gautam1858/shruti/docs/architecture-spec.md

# Shruti — Event-Native Protocol Emulator ASIC: Architecture Spec v1.0

Gautam Ramachandra · 23 September 2026 · v1.0 · Jane Street protocol emulator ASIC competition (Tiny Tapeout, IHP 130nm CMOS5L)

## What Shruti is

Shruti (Sanskrit: "that which is heard") is a protocol emulator ASIC that also listens. Two event-native engines speak UART, SPI and I2C from firmware, with low-speed USB and Manchester transmit as stretch goals. An on-die classifier, the Ear, identifies an unknown bus from its edge timing alone and flags traffic that fits nothing it knows. (Status, 8 Oct 2026: on simulated buses it identifies the classes it was trained on, but its out-of-distribution flag does not yet catch traffic it was not trained on; ear/REPORT.md.)

One hardware event stream (pin edges with 20 ns timestamps) feeds three consumers: firmware that speaks, rule monitors that check, and a learned model that identifies. That shared substrate is the design's one idea; everything else is sized around the memory it needs.

What is hard to copy is not the RTL, which the rules make open. It is the closed loop: the chip captures features of a new bus, the open-source pipeline trains a ternary classifier on the host, the weights load back into silicon, and a formal proof shows the on-die inference is bit-exact to the trained model. That loop needs hardware/ML co-design, edge quantization, waveform classification and verification skill in one team. Establish priority by building in public from day one, with a dated repo and a short write-up.

## Competition alignment

Every stated requirement in the [Jane Street brief](https://blog.janestreet.com/protocol-emulator-asic-competition/) maps to a concrete block; the Ear is the answer to "show us anything else your architecture makes possible".

| Brief requirement | How Shruti meets it |
| --- | --- |
| Tiny CPU with an ISA for reading pins, writing pins, counting cycles, exact timing | Two Event Machines (EMs); every instruction is anchored to a captured edge timestamp, so timing is set by hardware, not by instruction latency |
| Reprogrammable for new protocols after fabrication | EM firmware is host-loaded (32 x 16-bit words per EM); the Ear's weights are host-loaded too, so the identifier is retrainable after tapeout |
| UART, SPI, I2C first | Firmware library with cocotb tests against bus models; FPGA-proven against a USB-UART adapter, SPI flash and an I2C sensor. Status, 8 Oct 2026: the firmware is tested on the ISS against peer-device models and UART transmit runs on the RTL in cocotb; no FPGA build exists yet (planned for 6 Dec) |
| Stretch: low-speed USB | 1.5 Mbit/s = 33 core cycles per bit at 50 MHz; NRZI and bit-stuffing in firmware, CRC5/CRC16 in a small shared hardware unit (optional, ~150 cells) |
| Stretch: 10 Mbit Ethernet | Transmit through a ~150-cell hardware Manchester serializer fed from the OSR, host supplying preamble and CRC32; receive is a further stretch on DDR edge capture; bit periods must be whole cycles, so a 40 or 60 MHz core clock (section 11) |
| JTAG, SWD, PS/2, CAN | Firmware, after the core three; CAN needs an external transceiver and a wait-with-timeout for arbitration |
| Test RTL on an FPGA before the ASIC flow | Tang Nano 20K prototype from week 6; same RTL, same firmware. Status, 8 Oct 2026: not started |
| Novel design and verification methodology | Proof-carrying firmware, every protocol program proven against its contract before it can be loaded (section 10); golden-model differential testing, formal proofs on the scheduler, and a bit-exact formal equivalence proof of the on-die classifier (section 9). Status, 10 Oct 2026: four programs carry proofs (the SPI slave and the I2C target do not yet) and `shruti load` is not built; the Event Machine's scheduler, FIFO, PC and HALT properties are proved (verify/README.md); the classifier proof is planned for 13 Dec |
| IHP 130nm CMOS5L, Tiny Tapeout template, 8x4 tiles (confirmed by the organisers in November 2026; designed at 6x4 until then) | Budget in section 8 targets 60% utilisation; the area 8x4 adds goes to a third EM, 64-word program memory or full-size Watch, decided on the first 8x4 run |
| Open source | Apache-2.0 for RTL, firmware, models and the training pipeline; public repo from day one |
| Teams recommended | Planned as two roles (microarchitecture + physical design; ISA, toolchain, Ear, verification and write-up); decided 23 Sep 2026 to proceed solo, with the no-partner fallback in section 14 |
| Deadline 18 Jan 2027, March 2027 shuttle | Feature freeze 20 Dec 2026, submission 12 Jan 2027 (section 15) |

## Architecture overview

One event stream, three consumers: the Event Machines speak, the Ear listens, the monitors watch, and the flight recorder keeps the last 32 events for the host.

```mermaid
flowchart LR
  P[Bus pins<br/>8 bidir + 4 input-only] --> F[Sync + glitch filter<br/>2-of-3, 3-of-5 or bypass]
  F --> E[Edge detect +<br/>24-bit timestamp]
  E --> EM[Event Machines x2<br/>speak]
  E --> FX[Feature extractor<br/>speed-invariant]
  FX --> EAR[Ear classifier<br/>ternary MLP]
  E --> RM[Rule monitors x4]
  E --> RB[Flight recorder<br/>32-entry ring]
  EAR --> TR[Trigger logic]
  RM --> TR
  TR --> RB
  EM --> SCH[Scheduler<br/>time-compare]
  SCH --> P
  H[Host SPI +<br/>register map] --> EM
  H --> EAR
  RB --> H
  TR --> IRQ[IRQ + class LEDs]
```

Edges enter on the left, get filtered and timestamped once, and fan out to every block; only the scheduler drives pins, and only the host loads programs and weights. Single clock domain at a 50 MHz target (24 MHz fallback), synchronous reset, all state in flip-flops unless the SRAM rule in section 8 fires.

## Event-native datapath and ISA

Every timing-critical instruction is anchored to T, a per-EM time register that hardware sets to the timestamp of the last matched edge, so the edge decides the timing and instruction latency never does. This is the honest answer to "what would you do differently from PIO": PIO counts delays from when an instruction runs; Shruti schedules from when the bus event happened. The lineage is the channel time latches of NXP's eTPU, credited openly.

Per-EM state: PC (5 bits), T (24 bits) with a T_PASSED bit, X and Y counters (16 bits each), a bit-period register P (16 bits), ISR and OSR shift registers (16 bits each, with 5-bit counters), a shift configuration register (bit order, word length and autopull/autopush threshold per direction), two scheduler slots (24-bit compare, pin, value), a 12-bit pin snapshot latched at the last matched edge, per-pin push-pull/open-drain mode, and the TO, LATE, OVF and UNF flags. Instructions are 16 bits: a 4-bit opcode and 12 bits of operands; 32 words per EM. The encoding table below is a summary; [isa/isa.yaml](../isa/isa.yaml) (v1.1) is normative, and [isa-decisions.md](isa-decisions.md) records why each choice was made.

| Op | Instruction | Operands (bits 11..0) | Behaviour |
| --- | --- | --- | --- |
| 0 | HALT | reserved | Stop, raise IRQ. Opcodes 12-15 and illegal operands also halt, so blank (all-zero) program memory halts |
| 1 | WAIT pin, mode [, 2^n] | pin 4, mode 3, timeout 5 | Block until rise, fall, any edge, high or low level; T := match cycle, snapshot latched. Timeout 2^n cycles after T (n = 1..23): TO := 1, T := deadline, continue |
| 2 | OUT pin, v @T+d | pin 4, value 2, d 6 | Arm a scheduler slot to drive pin at exactly T+d (d = 0..63). v = 0, 1, OSR (consumes exactly one bit) or ~OSR (next bit inverted, not consumed). Blocks only while both slots are busy |
| 3 | IN pin @T+d / IN pin @snap | pin 4, snap 1, d 6 | Block until T+d and sample the pin, or read the snapshot without blocking; the bit goes into the ISR |
| 4 | ADDT d [, now] | now 1, d 11 | T := T + d, or T := max(T, counter + d): the anchor never moves backwards |
| 5 | ADDT P[/2\|/4\|/8] [, now] | now 1, shift 2 | As ADDT with d = P >> shift, so firmware never hard-codes the bit rate |
| 6 | SHIFT out\|in, lsb\|msb, n [, auto] | dir 1, msb 1, auto 1, n-1 4 | Configuration only: bit order, word length n (1..16) and the autopull/autopush threshold |
| 7 | PUSH [block] | block 1 | ISR word (1 or 2 bytes) to RX FIFO; non-blocking on full drops it and sets OVF |
| 8 | PULL [block] | block 1 | TX FIFO to OSR (1 or 2 bytes); non-blocking on empty leaves the OSR unchanged |
| 9 | SET pin, v [, pp\|od] / SET X\|Y\|P, imm | target 2, then pin 4, level 1, od 1 or imm 10 | Immediate pin drive and mode, or register load (0..1023; the host writes all 16 bits of P) |
| 10 | JMP [cond,] target | cond 3, pin 4, target 5 | always, TO, LATE, TXE (TX FIFO empty), !OSRE (OSR not empty), X--!=0, Y--!=0, pin high, pin low on any of the 12 pins |
| 11 | SYNC set\|wait, n | op 1, flag 2 | Four flags shared by the EMs and the host; wait blocks until the flag is set, then clears it |

Timing model: one cycle per instruction unless it blocks; all time comparisons are modulo 2^24, and a time t is in the future iff (t - counter) mod 2^24 is in [1, 2^23). An OUT@ whose target is not in the future, or an IN@ whose target has passed, still executes but sets the sticky LATE flag; LATE is visible to JMP and to the host, and every firmware contract requires that it is never set. Inputs are seen through the synchroniser, L = 2 cycles late, so a program that runs ahead of its own scheduled outputs should wait on edges rather than levels: a level WAIT can match the pin's old level before a scheduled change becomes visible. At reset T equals the counter, X, Y and P are 0, and CFG is LSB-first with 8-bit words; the host may write P and CFG before starting an EM. A bit period is one "ADDT P" step up to 65,535 cycles (763 baud at 50 MHz); slower rates load P with 1/k of the period and take k steps per bit (300 baud: P = 55,556, three steps).

UART transmit at bit period B (host sets P = B, TX pin push-pull) is twelve words. ISS-verified: the pin trace is cycle-exact for 256 random (byte, B) pairs with B from 8 to 65,535, back-to-back frames are exact down to B = 4, and B <= 2 sets LATE.

```
        SET   tx, 1              ; line idles high
        SHIFT out, lsb, 8        ; LSB first, 8 data bits
top:    PULL  block              ; next byte -> OSR
        ADDT  2, now             ; T := max(T, now + 2): never before the previous stop bit ends
        OUT   tx, 0 @T+0         ; start bit
bit:    ADDT  P                  ; T += B
        OUT   tx, OSR @T+0       ; data bit, consumes one OSR bit
        JMP   !OSRE, bit         ; 8 data bits
        ADDT  P
        OUT   tx, 1 @T+0         ; stop bit
        ADDT  P                  ; T = end of stop bit
        JMP   top
```

Back-to-back bytes start exactly at the end of the previous stop bit; after idle, the start bit follows 2 cycles after the PULL returns. The two scheduler slots throttle the loop so it never runs more than two edges ahead. The v1.0 example (`ADDT 0, now` then `OUT @T+0`) was late by construction, since the slot was armed for a cycle that had already passed; that case is now an ISS regression test.

Three things this gives that PIO does not: hardware WAIT with timeout (needed for CAN arbitration, I2C clock stretching and USB turnaround), deferred hardware sampling at a computed time (a mid-bit read is one instruction), and a snapshot of every pin at the edge so a slave can read data exactly at the clock edge. Measured on the ISS (fw/), the v1.0 claim that UART, SPI and I2C each fit in 12 words was wrong for everything but UART transmit: UART transmit is 12 words, UART receive 17, SPI master 19 in each of modes 0-3 (the mode is set at assembly), and I2C master write (multi-byte, ACK check, clock stretching, STOP and bus-free time) exactly 32, with its bit order set by the host through EMx_CFG. So 32 words hold UART transmit plus receive (29) or SPI master plus UART transmit (31) in one EM, but I2C master fills an EM on its own; SPI slave is 18 words with CPHA = 0 and 15 with CPHA = 1, and an I2C target that receives writes is 32 (with no compare instruction it cannot match addresses, so it stretches SCL while the host answers each byte). I2C speed is set at assembly: the standard build holds SCL low and high for P, the fast build low for P and high for P/2, so 100 kHz (P = 249) and 400 kHz (P = 82) are both exact. Speed limits at 50 MHz, also measured: UART transmit B >= 4 cycles, UART receive B >= 9 (both tested at every common baud rate from 300 to 3 Mbaud, with a three-step SLOW build below 763 baud, where P no longer fits 16 bits), SPI master SCK up to 5 MHz (P >= 5), SPI slave SCK phases of at least 4 cycles, in every mode, I2C target SCL high of at least 4 cycles and low of at least 11.

## The Ear: identifier and retraining loop

The Ear turns raw edge timing into 72 speed-invariant features in hardware, classifies them with a host-loaded ternary MLP, and reports a class, a confidence flag and an out-of-distribution flag. Its per-pin bit-period estimate gives the protocol's speed without any ML.

Speed invariance is the design insight: intervals are coded in the log2 domain (leading-one position plus two mantissa bits, 6 bits total), and the histogram bins each interval by its ratio to the shortest interval seen so far in the window (a running minimum; the histogram shifts when a shorter interval arrives). A 9600-baud UART and a 1-Mbaud UART then produce the same interval histogram, exactly for power-of-two speed ratios and to within a half-octave bin otherwise, which is what lets a model this small generalise; the shortest-interval code and the edge counts still carry the absolute speed (the v1.0 text claimed the whole feature vector was the same, which it is not). In practice the window limits this: at 9,600 baud a 65,536-cycle window (1.3 ms) holds about 6 edges, so the activity gate flags almost every window (ear/REPORT.md, Coverage by speed); a prescaler for the Ear's timebase is planned before the feature freeze. The bit-exact definition is ear/SPEC.md.

| Feature group (4 monitored pins, host-selected) | Per pin or pair | Bits | What it separates |
| --- | --- | --- | --- |
| Interval-ratio histogram, 8 bins (1x, 1.4x, 2x, 2.8x, 4x, 5.7x, 8x, 11x+) | 8 x 6-bit counters | 48 | UART frames vs SPI clock vs Manchester (only 1x and 2x) |
| Shortest interval code (bit period), longest in-burst interval code | 2 x 6 bits | 12 | Speed estimate; CAN (max run 5) vs USB (max run 6) vs UART (up to 9) |
| Edge count and time-high fraction in the window | 2 x 8 bits | 16 | Idle polarity, clock lines (50% duty), activity |
| Pair: b-edges within 4 cycles of an a-edge | 12 pairs x 6 bits | 72 | Differential pairs (USB D+/D-), data-follows-clock |
| Pair: b-edges while a is high | 12 pairs x 6 bits | 72 | I2C (SDA changes only while SCL low, except START/STOP) vs SPI modes |

A window closes after 256 edges or 65,536 ticks, whichever comes first; the features are snapshotted and the counters restart. A tick is 1, 4, 16 or 64 cycles, set by the host (EAR_CFG): at 64 a window spans up to 84 ms, so a 9,600-baud UART or a PS/2 keyboard fills it with edges instead of timing out with a handful. Inference is a serial multiply-accumulate: one ternary weight per cycle into a single 16-bit accumulator (add, subtract or skip), ReLU and a host-set right shift to 8 bits as each hidden unit completes, then an 8-way output layer. 72 x 8 + 8 x 8 = 640 weights at 2 bits plus 8 signed 8-bit hidden-unit thresholds = 1,344 bits, so a full pass takes 640 cycles plus 8 for the argmax, 648 cycles or 13 us at 50 MHz (the v1.0 text said one feature per cycle with 8 accumulators, which contradicts its own ~700-cycle figure and would need 8 adders). Class = argmax; confident = (best - second best) above a host-set margin; OOD = best logit below a host-set floor, plus an activity gate. OOD is the weakest link and is validated empirically (section 9), not assumed.

The retraining loop is what makes the Ear reprogrammable after fabrication, and it is the part competitors will not have:

1. Capture: with the chip watching the new bus, the host reads feature snapshots (72 bytes each) across several speeds and devices; the user supplies the label. A few hundred snapshots per class is enough.
2. Train: quantisation-aware training with ternary weights and integer thresholds (numpy, `python -m shruti train`); every feature is 6 bits, and the pins are presented in a canonical order (sorted by activity) so the model does not depend on which physical pins the bus is wired to. The same pipeline bootstraps the first model from a protocol simulator that emits edge streams with jitter and glitches, before any hardware exists.
3. Verify: a bit-exact Python reference and the RTL (cocotb) run the same snapshots and must produce identical logits; the formal datapath proof in section 9 covers every weight set once.
4. Load: the host writes 1,344 bits over SPI at boot, in under a millisecond.

Shipped as a CLI, `shruti teach`, `shruti train`, `shruti load`, this is the demo: teach the chip an undocumented bus in minutes, with no re-spin. Status, 8 Oct 2026: `shruti train` exists; `shruti teach` and `shruti load` are planned.

## Watch: rule monitors, anomaly trigger, flight recorder

Watch is a hardware protocol trigger with a 32-event pre-trigger memory, the thing a logic analyser does, driven by rules the user writes and by anomalies the Ear learns. It observes only; nothing in Shruti alters the bus.

Four rule monitors, each host-configured: an edge to match (pin, rise, fall or any), a guard over the 12-pin snapshot (mask and value, so "edge on A while B high and C low"), optional bounds on the interval since that pin's previous edge (two 6-bit log codes), and an action: count, trigger, halt the EMs, or set a SYNC flag. Examples: SPI data edge within one cycle after the sampling clock edge (setup violation); UART pulse shorter than half a bit period (glitch or baud mismatch); USB single-ended zero longer than two bit times (reset).

Trigger sources: any rule, the Ear's OOD flag, an Ear class change, the host, or the external trigger-in pin. On trigger the recorder keeps N more events (host-set, 0 to 31) and freezes, raises IRQ, drives trigger-out so a scope can capture the same moment, and optionally halts the EMs. The recorder holds 32 entries of 21 bits: 16 low timestamp bits, 4-bit pin, 1-bit edge, read out over SPI.

Status, 8 Oct 2026: Watch is not built. The first build is the cut level (2 monitors, a 16-entry recorder), grown only if place-and-route leaves room.

Rules and the learned model are complementary on purpose: rules catch the violation you can name, the Ear catches the traffic you cannot, and both land the raw edges in the same buffer. (Status, 8 Oct 2026: the Ear's unknown flag does not yet catch untrained traffic; see the OOD row of the risk table.)

## I/O plan and host interface

Twelve watchable bus pins, a 3-wire host SPI, and five status outputs use all 24 Tiny Tapeout signals; the demo board's own RP2040 is the host, so the demo needs no extra hardware.

| Signal | Use |
| --- | --- |
| uio[7:0] | Bus pins B0-B7, bidirectional. Per-pin push-pull or open-drain mode (OUT value 1 releases the pin), which is how I2C and 1-Wire drive without extra logic |
| ui_in[0..2] | Host SPI: SCK, MOSI, CS_n (mode 0, up to core clock / 8 = 6.25 MHz; v1.0 said / 4, which a slave that synchronises SCK into the core clock cannot meet) |
| ui_in[3] | Trigger-in from a scope or another Shruti |
| ui_in[4..7] | Monitor-only bus pins M0-M3; EMs can WAIT and IN on them, the Ear and monitors can watch them |
| uo_out[0] | Host SPI MISO |
| uo_out[1..2] | IRQ, trigger-out |
| uo_out[3] | Ear confident flag |
| uo_out[4..6] | Ear class, 3 bits, straight to the demo board LEDs: the last window that was confident and not OOD, so the LEDs hold an answer between windows (0 after reset) |
| uo_out[7] | Ear OOD flag |

Register map over SPI (8-bit command, 8-bit address, data; the part built so far, with its timing, is in docs/host-interface.md): PROG0 and PROG1 (32 x 16 bits each), WEIGHTS (1,344 bits), FEATURES (72 bytes, read), RECORDER (32 x 21 bits, read), MON0-3 config, EAR config (4-pin select, margin, floor, window length), EM control (run, halt, reset, PC), EMx_P bit period and EMx_CFG shift configuration, TX and RX FIFOs (4 deep per EM), STATUS (including the sticky LATE, OVF and UNF flags per EM). Every bit of program, weights and configuration is host-loaded; nothing protocol-specific is fixed in silicon.

Electrical: logic levels are whatever the Tiny Tapeout board provides (the organisers confirm 3.3 V I/O on the demo board; pull-ups, transceivers and level shifting go on a Pmod). The firmware library defaults to Tiny Tapeout's recommended Pmod pinouts on `uio` (fw/README.md), so standard Pmods plug in. I2C uses open-drain mode with external pull-ups; low-speed USB needs the external 1.5 kohm pull-up on D- and a level check, proven on the FPGA before it is claimed.

## Memory-first area budget

The design holds about 5,000 bits of state (the table's sum; v1.0 of this text said 5,400) and an estimated 10,900 cells (10,700 without the two Ethernet stretch blocks), against roughly 14,400 usable cells (24 tiles at ~1,000 cells per tile, 60% utilisation for routing and clock tree). That leaves ~24% headroom before the first synthesis run; estimates are pre-synthesis and carry +/-30%, so weekly measured numbers replace them from week five.

| Block | State bits | Est. cells | Note / cut option |
| --- | --- | --- | --- |
| EM program memory, 2 x 32 x 16 | 1,024 | 1,600 | Flops plus 32:1 read mux; cut: share one 32-word memory between EMs |
| Event Machines x2 (registers, decode, shifters, 3 comparators each) | ~400 | 2,400 | Cut: single EM |
| ISA v1.1 additions x2 (P, CFG, T_PASSED, LATE/OVF/UNF, P >> s mux, ADDT-now compare) | ~66 | 300 | Cut: drop the P/4 and P/8 forms |
| Scheduler pin drive, open-drain modes | ~30 | 200 | |
| Pin sync, per-pin glitch filters (bypass, 2-of-3 or 3-of-5 majority; 3-of-5 rejects pulses under 60 ns and suits buses up to a few MHz), edge detect, 24-bit timestamp | ~230 | 400 | |
| Host FIFOs, 4 deep x 8 bits, TX and RX per EM | 128 | 250 | |
| Host SPI, register map, read mux | ~60 | 800 | |
| Feature extractor, 4 pins + 12 pairs | ~600 | 1,200 | Cut: 3 pins, 6 pairs |
| Ear classifier: weights as a shift chain, one 16-bit accumulator, 8 hidden bytes, 8 12-bit logits, argmax | ~1,500 | 2,200 | No feature snapshot: counters pause 648 cycles during inference. Cut: hidden layer 8 to 6 |
| Rule monitors x4 | ~210 | 400 | Cut: 2 monitors |
| Flight recorder, 32 x 21 bits as a shift ring | 672 | 800 | Shift-out readout avoids a read mux. Cut: 16 entries |
| CRC5/CRC16 unit (USB), optional | 16 | 150 | Drop if USB is not attempted |
| Manchester serializer (Ethernet transmit): divider, XOR, differential drive | ~24 | 150 | Stretch (section 11); first on the cut list |
| DDR edge capture, 12 pins (10 ns timestamps) | ~48 | 60 | Stretch; half-cycle paths need explicit timing constraints |
| **Total** | **~5,000** | **10,900** | 14,400 usable at 6x4; ~18,000 at 8x4 |

SRAM decision rule: use one SRAM macro for program, weights and recorder only if a single macro of at least 4 kbit fits in 3 tiles or fewer including its keep-out, checked against the CMOS5L template and the ttihp0p2 SRAM example in week one. Otherwise stay with flip-flops: a first tapeout with no macro carries no LEF, timing-model or placement risk, and the budget above already fits without one.

SRAM check, 23 Sep 2026. The CMOS5L PDK (IHP-Open-PDK at the revision the Tiny Tapeout flow pins) links its SRAM library to the SG13G2 macros, so the ttihp0p2 macros are available. The smallest, RM_IHPSG13_1P_64x16_c2 (1 kbit, one port), is 236.8 x 64.4 um = 15,240 um2; the 16 kbit 1024x16 is 236.8 x 336.5 um, about 2.1 tiles. Read access (clock to data out) is about 5 ns at the slow corner, a quarter of a 20 ns cycle. The rule's premise is wrong, though: one single-port macro cannot serve two EMs fetching an instruction every cycle, the Ear reading a weight every cycle during inference and the recorder writing at the same time, so "one macro for everything" would stall the EMs. The workable form is one 64x16 macro per EM (which also doubles program memory to 64 words), about 30,500 um2 plus keep-out, against 83,900 um2 (2,921 cells, measured) for today's 2 x 32 x 16 flops with their write enables and read muxes. The saving, about 50,000 um2 or 5 to 6% of the core, is not needed at the measured utilisation below, and a macro needs changes to src/config.json and a synchronous-read fetch. Decision: stay with flip-flops; revisit only if placement or routing runs short. The flop memory sits behind one read port per EM, so the swap stays local if it is ever made.

SRAM revisited, 4 Oct 2026, when the Ear pushed density to 64%. The Ear's weights, read strictly in sequence, would suit a single-port macro, and a 256x16 macro (28,100 um2) would replace about 85,000 um2 of flops. But on this shuttle the macro cannot be powered within the rules. Tiny Tapeout's CMOS5L precheck forbids TopMetal1 in projects (tt-support-tools, precheck/tech_data.py), and project power must be Metal4 stripes. The macro's power pins are Metal4 columns inside its own footprint, where Metal1-4 are blocked, so they can only be tied together and to the supply by straps on TopMetal1. The SG13G2 reference design does exactly that, but on SG13G2 the project power grid itself is on TopMetal1. Integrated clock gating would have saved the per-bit hold multiplexers instead, but the library marks its clock-gate cell (sg13cmos5l_lgcp_1) dont_use. Both are open questions for Tiny Tapeout (below). Until then, area comes from the design itself.

Correction, 10 Oct 2026: the SRAM conclusion above was wrong. The organisers confirm that IHP SRAM macros may be used, more than one if they fit and pass precheck, and Ken Pettit's walkthrough (https://kdp1965.github.io/ihp-um-janestreet-prism/ihp_sram_macro.html) powers a 512x32 macro on Metal4 alone, with no TopMetal1:
- the tile's Metal4 power stripes are placed on the macro's Metal4 supply columns (FP_PDN_VPITCH 44.96 um, FP_PDN_VOFFSET 6.15 um);
- PDN_MACRO_CONNECTIONS ties the macro's VDD! and VDDARRAY! to them.

The straps this section said were needed on TopMetal1 are not needed. The walkthrough turns off Magic DRC and the illegal-overlap check and relies on KLayout DRC and LVS. The precheck was updated in September 2026 to accept the macro's marker layers. Whether this passes on Shruti is for a GDS and precheck run to show. The candidates are the Ear's weight ring (read strictly in order) and Watch's recorder (written in order). Moving both should free an estimated 60,000 to 80,000 um2, which is an estimate, not a measurement. Clock gating stays out: the clock-gate cell is still dont_use.

Measured, 23 Sep 2026 (synth/synth.sh: Yosys mapping onto the CMOS5L cells, before placement). The 6x4 die in the Tiny Tapeout flow is 1,289.3 x 710.6 um = 0.92 mm2 (core 0.90 mm2), more than the brief's estimate of 0.7 mm2. Built so far: two EMs, flop program memory, input path, counter, pin drivers, SYNC and the host SPI with its register map, 10,090 cells and 179,000 um2 of cell area, of which 1,826 flip-flops are half. That is about 20% of the core. Per block: one EM 2,872 cells (39,300 um2); host SPI 244 cells (4,400 um2); program memory, input path and register map 3,826 cells (97,300 um2). Against the table above, these blocks came in about 65% over their cell estimates (program memory 2,921 cells, not 1,600; each EM 2,872, not 1,350). The rest of the design, at the same overrun, would bring the total to roughly 18,000 cells and 330,000 um2, about 37% of the core. So the cell-count budget in this section, 1,000 cells per tile, is about half what the measured die holds (average cell 17.8 um2, 60% target density: roughly 30,000 cells). The binding limits are placed density, routing and timing at 50 MHz, not the cell count, and the checkpoint criteria below use them. The GDS action's placed and routed numbers replace these as each block lands.

Placed and routed, 24 Sep 2026 (LibreLane in the GDS action, commit 1d5c2fd): 16,940 cells after buffering and clock tree, 255,000 um2, 28% utilisation, 0 DRC and 0 antenna violations; power about 6.8 mW. Timing at 50 MHz closes at all three corners: setup slack +0.06 ns at slow (1.08 V, 125 C), +7.4 ns at typical and +11.2 ns at fast; no hold violations. The flow reports 16 max-slew warnings at the slow corner. Getting there took three runs. The first missed the slow corner by 5.0 ns and the second by 2.3 ns. Three structural changes closed it, none visible at the ISA level: a registered instruction fetch, a T - counter register, and a registered filter output. The slow-corner margin is thin, and the Ear and Watch will add load on the same input path, so every block that lands from here gets a place-and-route run before the next starts.

Placed and routed with the Ear, 4 Oct 2026 (commit b3ea208): 606,000 um2 of standard cells, 67% utilisation, of which 110,000 um2 are timing-repair buffers; 0 DRC and 0 antenna violations, no hold violations, 12 max-slew and 1 max-cap warnings. Setup slack at 50 MHz is +3.37 ns at typical and +7.76 ns at fast. The slow corner misses by 4.18 ns on 47 endpoints, and every one of them starts at the rst_n pin; no register-to-register path fails. The run before it, without the Event Machine and Ear restructuring, missed by 7.6 ns on register paths. The endpoints are the Event Machine's fetched time operand and its negation. The first fix (commit 8648628) removed a redundant reset term from the operand precompute; the next run missed by 5.71 ns on 67 endpoints, still all from rst_n. The netlist showed why: synthesis shares one 24-bit negator between the jump and sequential operands behind a multiplexer, and the reload condition "reset or stopped" sat in that multiplexer's select, so the reset pin (constrained to arrive 4 ns into the cycle) and its fanout tree of about 4,400 flops still fed the subtract. The operand registers now reload on "stopped" alone; run is itself cleared by reset, so the reload happens one cycle into reset with P already zero, and reset is always held longer than that. The longest combinational path from rst_n to any flop in the synthesised netlist went from 22 cell levels to 8. The differential and gate-level tests pass unchanged.

Third run, 4 Oct 2026 (commit 25841fc): no path from rst_n fails any more. Slow corner -1.73 ns on 23 endpoints, typical +6.35 ns, fast +10.83 ns, 68% utilisation, 0 DRC, no hold violations, 8 max-slew warnings. All 23 endpoints are in Event Machine 1: 22 bits of the operand negation and one byte of the RX push register, all from a single instruction bit. The synthesis log explains the rest. Yosys's resource-sharing pass had merged each EM's two program-memory reads (pc + 1 and the jump target) into one read port, and the two operand shifters into one, because a mux selected between them and the pass could prove they were never needed together. That put the decode of "done" and "jump" in front of an address mux, a 32-way read multiplexer and the operand decode in series, and the merged shifter gave the RX path a false dependence on the memory read. Two changes, neither visible at the ISA level: the jump/sequential choice is now an AND-OR, which keeps both reads live so nothing is merged (the log now reports no shared cells; the cost is about 13,500 um2 of cell area for the second read multiplexer per EM); and the negated operand is gone. "The target is now" is dT + d = 0 and "one cycle away" is dT + d = 1, and A + B = K can be tested bit by bit without carry propagation: A ^ B ^ K must equal the carry K demands from the bit below, (A | B) for K = 0. That removes a 24-bit negator per EM and 46 flops. The identity was checked exhaustively at 10 bits (it is bit-local, so width does not matter), and the differential test compares every cycle against the ISS. In the synthesised netlist the deepest path from the fetched instruction to the operand register went from 27 cell levels to 19.

Fourth run, 5 Oct 2026 (commit 0beaee3): timing at 50 MHz closes at all three corners with margin. Setup slack +4.24 ns at slow (1.08 V, 125 C), +9.63 ns at typical and +11.79 ns at fast; no setup or hold violations (worst hold slack +0.05 ns). 619,000 um2 of standard cells, 69% utilisation, of which 113,000 um2 are timing-repair buffers; 0 DRC and 0 antenna violations; 10 max-slew and 1 max-cap warnings; power about 16 mW. The gate-level test in the GDS action passes on the routed netlist. So Event Machines, program memory, input path, host SPI and the Ear fit the 6x4 die at 50 MHz, with 4 ns of slow-corner margin; Watch has to fit in the remaining density and keep that margin, and gets its own place-and-route run before anything else lands.

Signoff gate, 8 Oct 2026. The GDS workflow now has a signoff job (verify/signoff.py) that reads the post-route metrics. It fails on negative setup or hold slack at any corner, or on DRC, antenna or LVS errors. It warns when slow-corner setup slack is under +4.0 ns or the worst hold slack is under the flow's GRT_RESIZER_HOLD_SLACK_MARGIN. Its first runs were on commits d31dad0, 98096c4 and 3d26e12, which add only CI, the formal properties (inside `ifdef FORMAL`, which the flow never defines) and docs. They reproduce the fcafc0b numbers exactly and pass:
- setup slack +4.24 ns slow, +9.63 typical and +11.79 fast;
- worst hold slack +0.0495 ns;
- 619,342 um2 of cells, 68.6% utilisation, 113,131 um2 of timing-repair buffers;
- 0 DRC and 0 antenna violations.
They warn on the hold margin and on 10 max-slew, 1 max-cap and 308 max-fanout violations, the electrical items left for signoff.

8x4 is confirmed (organisers, November 2026): the die grows from 1,289.3 x 710.6 um to 1,724.2 x 710.6 um, 34% more. The design moves to 8x4 as it is, and the extra area is decided on the first 8x4 run's utilisation and timing: a third EM (2,400 cells), 64-word program memory per EM (1,600 cells; an ISA change, since JMP needs a 6-bit target), or Watch at full size (4 monitors, a 32-entry recorder), keeping utilisation under 65%.

## Verification methodology

The distinctive claim is a bit-exact formal proof that the on-die classifier computes what the trained model computes, for every weight set, on top of a conventional golden-model, formal and protocol-level stack; every method's bug count is reported in the write-up.

1. Golden models first. A cycle-accurate Python ISS for the EMs, with assembler and disassembler round-trip tests, is written before any RTL and is what the firmware library is developed on. The feature extractor and classifier have one bit-exact fixed-point reference shared with the training pipeline's export step.
2. Differential testing. Constrained-random EM programs (valid targets, reachable waits) run on the RTL in cocotb and on the ISS with the same random pin stimulus; pin drives, T values and FIFO contents must match cycle-exactly. Random edge streams do the same for the feature extractor.
3. Protocol level. cocotb bus models for UART, SPI and I2C exercise the real firmware; mutation tests (missing ACK, bad stop bit, injected glitches, clock stretching) must fire the right monitor or trigger.
4. Formal, with SymbiYosys. Scheduler: an armed slot fires at exactly its compare time, never earlier, never twice. Capture: no edge on a filtered pin is lost while an EM waits on it. FIFOs: no silent overflow or underflow. Recorder: after a trigger, exactly N more entries, then frozen. PC always in range; illegal opcode halts.
5. Formal, the classifier. A k-induction invariant over the MAC cycle counter shows each accumulator equals the running dot product of features and ternary weights as specified, for all weights and features; the argmax and threshold logic is proven equivalent to the reference by SAT. The datapath is small enough that this closes; each new weight set then needs only the differential run.
6. ML validation. Held-out captures from the FPGA, at least five devices per class across speeds, give a confusion matrix. OOD is tested by training without JTAG and PS/2 and reporting the flag rate on them against the false-alarm rate on known classes. Glitch and speed-extreme robustness are reported too.
7. Physical. Gate-level simulation of the key tests after place-and-route, timing signoff at 50 MHz, and a 24-hour FPGA loopback soak on real devices.

Status, 8 Oct 2026:
- 1 and 2 are done for the Event Machines and the Ear (test/test.py; 60 random two-EM programs match the ISS every cycle; the Ear's 72 features match ear/features.py window by window).
- 3 is partial: the firmware runs on the ISS against peer-device models, with injected faults (a framing error, a glitch, NACKs, clock stretching; fw/tests); cocotb bus models on the RTL, and the monitors they should fire, are planned.
- 4 is partial: 27 Event Machine properties (scheduler, LATE, WAIT timeouts, FIFOs, PC, HALT) are proved by k-induction, every one with a planted bug that fails it (verify/README.md). Capture and the recorder are planned; the recorder waits for Watch.
- 5 is planned for 13 Dec.
- 6 is on simulated buses only (ear/REPORT.md); FPGA captures wait for the FPGA.
- 7 is done for the current blocks (gate-level simulation and signoff at 50 MHz in CI, spec section 8); the FPGA soak waits for the FPGA.

Traceability: each ISA line maps to an ISS routine, a formal property and a test in a matrix in the repo, and GitHub Actions runs the whole stack on every push, alongside the Tiny Tapeout GDS action. The RTL language is decided in section 12; either way the ISS is the single source of truth and the prover in section 10 sits on top of it.

## Proof-carrying firmware

Every program in the firmware library ships with a machine-checked proof that it meets its protocol contract, produced by `shruti prove` in seconds, and `shruti load` refuses an unproven program unless forced (Status, 10 Oct 2026: four programs carry proofs: UART transmit and receive, SPI master in modes 0-3 and I2C master in both speed builds; the SPI slave and the I2C target are tested but not proved; `shruti load` is not built, so nothing enforces the refusal yet). Nobody proves PIO programs; Shruti's are small enough to prove, and that is the methodology claim the write-up leads with. Silicon cost: zero.

A contract is a short declaration over the pin trace. Per pin, an expected run of intervals as multiples of a symbolic bit period B (tolerance 0 cycles for generated timing, +/-k cycles for sampled timing); invariants such as "no SDA edge while SCL is high except START and STOP" or "data stable for at least s cycles before the sampling edge"; and response bounds such as "replies within N x B of the last input edge". Contracts for UART, SPI, I2C, PS/2 and low-speed USB framing live in the repo beside the programs.

Method: symbolic execution of the ISS. A program is at most 32 words, its loops are bounded by the X and Y counters, and its timing is arithmetic on T, so with the data bytes and B left symbolic the executor produces the pin trace as symbolic edge times and Z3 decides the contract (linear integer arithmetic for timing, bit-vectors for data). The UART transmit contract over all 256 bytes and every B from 8 to 65,535 cycles closes in about 0.5 s (prover v0, two symbolic frames with symbolic arrival times), and broken variants return counterexamples that the concrete ISS reproduces. An induction proof over the loop head then extends it to any number of frames: the base case and the step together take about 0.2 s. Reactive contracts followed: the UART receiver is proved against a symbolic peer with edge jitter up to P/16 (P = 16..65,535, and from P = 9 without jitter margin), and the SPI master's timing and data in both directions against a slave answering 1 or 2 cycles after each edge (P = 5..65,535). The I2C master is proved for one write transaction against a symbolic slave that ACKs or NACKs each byte and stretches the clock, in its standard and fast builds (P = 65..2,000, about 30 s each); the bus-free time between transactions is measured on the ISS but not yet proved. Reactive programs (slave, receive) are checked against a symbolic input trace constrained by the peer's contract.

Chain of trust, stated in the write-up exactly like this: the RTL matches the ISS by bounded formal equivalence of the Event Machine against a Verilog transliteration of the ISS semantics (SymbiYosys, depth at least the longest instruction) plus constrained-random differential testing; the ISS running the program satisfies the contract by Z3. That is a proof at the ISS level with the RTL bounded-equivalent and tested, not "fully verified silicon", and it is still stronger than anything a PIO program has. Status, 8 Oct 2026: the bounded equivalence check is not built. Today the RTL-to-ISS link is cycle-exact differential testing plus 27 SymbiYosys properties of the Event Machine, proved by k-induction against times computed from isa.yaml (verify/README.md).

What it buys in the competition: firmware for a protocol the chip was never designed for is accepted or rejected by the prover, and the accepted program loads with no code review. That is the flexibility the organisers judge first, made checkable. Milestones: UART transmit contract proven by 25 Oct; SPI and I2C by 29 Nov; the "PS/2 firmware, prover accepts" demo by 20 Dec.

## Ethernet stretch: Manchester serializer and DDR capture

10BASE-T transmit is a ~150-cell hardware serializer, not firmware; receive is a further stretch on DDR edge capture. Almost no entry will attempt the brief's second stretch goal, and the demo is unambiguous: a switch's link LED comes on, then tcpdump on a laptop shows a frame sent by a 0.7 mm2 chip.

Transmit: an Event Machine cannot issue an instruction per half-bit at 10 Mbit/s, so Ethernet mode routes the OSR through a Manchester serializer: a programmable divider makes the bit clock, each bit is XORed with it to give the mid-bit transition, and the result drives two bus pins as TX+ and TX-. The host supplies preamble, frame and CRC32; the EM only pulls bytes, and the serializer auto-pulls from the OSR. Link: the EM emits a 100 ns normal link pulse every 16 ms with one scheduled OUT pair, which is what lights the LED.

Clock: a bit period must be a whole number of cycles. At 50 MHz a half-bit is 2.5 cycles, so Ethernet means a 40 MHz core (4 cycles per bit) or 60 MHz (6 cycles per bit); the week-one clock measurement decides, and every timestamp figure in this spec scales with it. 10BASE-T needs +/-100 ppm, which the demo board's crystal-derived clock meets.

Electrical: 3.3 V pins through series resistors into a MagJack transformer, as bit-banged 10BASE-T from microcontroller GPIOs has shown to work; proven on the FPGA before it is claimed, never on silicon first.

Receive: DDR capture samples each pin on both clock edges (two flops and a mux per pin, ~60 cells for 12 pins), giving 10 ns timestamps at 50 MHz. Manchester decode then runs in firmware from the timestamp stream or in a ~150-cell hardware decoder. DDR capture also doubles timing resolution for the Ear and Watch, so it earns its place even if receive never ships; its half-cycle paths need explicit constraints in the flow. Both blocks sit at the top of the cut list.

## Toolchain decision: Hardcaml or Verilog

Decided 23 Sep 2026: Verilog, solo. The Event Machines, host SPI and pin drivers are in `src/` and match the ISS cycle for cycle in cocotb (test/test.py). The reasoning below is kept as it was written.

Decide at the partner meeting on 11 Oct: RTL in Hardcaml if the RTL owner will work in OCaml, otherwise Verilog. The ISS, assembler, prover and Ear pipeline stay in Python either way, and the ISS is the single source of truth: instruction encodings are generated from one table for the ISS, the assembler and the RTL, so the two languages cannot drift.

Why Hardcaml: the judges built it. hardcaml_waveterm expect tests (the ASCII waveforms featured on their blog) and hardcaml_verify (SAT-based bounded checks) are the tools they read fluently, and Hardcaml generates the Verilog the Tiny Tapeout flow needs, so nothing changes downstream. An entry written in their language and tested in their idiom will be read more carefully than one that is not.

Cost and risk: two to three weeks of OCaml ramp for the RTL owner on a design this size; cocotb protocol tests then run on the generated Verilog, and the formal suite runs on it too. If Verilog: the Yosys-synthesisable SystemVerilog subset, cocotb and SymbiYosys, which is fully adequate and only loses the fit bonus. Do not split the difference; one language for all RTL.

## The demo

One five-minute video, recorded on the FPGA prototype in December and re-shot on silicon if chips come back, is the submission's centrepiece; the write-up and the repo exist to back it up. The sequence:

1. Clip the chip onto an undocumented bus: the internal I2C of a cheap consumer device, or a UART console.
2. The Ear's LEDs show the class and the speed register shows the bit period.
3. A Watch rule triggers and the flight recorder dumps the frames.
4. Firmware for the bus is written from its datasheet (or from the captured frames).
5. `shruti prove` accepts it. If a first attempt was rejected, show that too; judges trust a counterexample more than a green tick.
6. `shruti load`, the chip talks to the device, the host shows the data.
7. Ethernet: the switch link LED comes on, then tcpdump shows the frame.
8. Thirty seconds of fuzzing: mutated frames against the device, response latencies read at 20 ns.

Deliverables in the submission: the video, the README pitch, this spec, and a verification report whose centre is a bugs-found-per-method table. The organisers' checklist (9 Oct 2026): a public repository with the RTL, tests and a passing GDS and precheck from the Tiny Tapeout flow; architecture and instruction-set documentation; the assembler with example programs; and a write-up of the verification approach.

## Risks and cut list

The two risks that decide the outcome are area after synthesis and the Ear generalising to real hardware; both have a fallback that still yields a valid submission.

| Risk | Early signal | Response |
| --- | --- | --- |
| Area overrun after synthesis (+20-30% over estimate is normal) | Week-5 yosys cell count above 13,000 | Apply the cut list below, in order |
| Timing does not close at 50 MHz | Post-route slack negative in week 13 | Run at 24 MHz: USB becomes 16 cycles per bit, still workable; Manchester transmit is dropped |
| Ear misclassifies real devices | Confusion matrix below 90% on FPGA captures (on simulated buses the first model reached 86.6%; the Phase B recipe, an exact search on the integer model, reaches 92.8%, and 94.4% with each bus at the prescaler a host would pick, weakest on UART and Manchester) | Fine-tune on FPGA captures; if still weak, ship the Ear as beta and keep features plus bit-period reporting, which are useful alone |
| OOD flag noisy or blind | False alarms above 5% on known classes; or unknown protocols not flagged. Measured on simulated buses (ear/REPORT.md, first model, 8 Oct 2026): 7.5% false alarms; the logit floor flags 0% of a 20 kHz PWM, WS2812 LED data and random edges on four pins, and 0% of held-out JTAG/SWD and PS/2. A distance-to-class-prototype test on the hidden layer flags 15% of JTAG/SWD and 4% of PS/2 at 5% false alarms, or 47% and 4% at 12%. Phase B model before foreign calibration (Nov 2026): 3.8% false alarms; the floor flags none of the foreign signals, and the prototype test flags 25% of JTAG/SWD and 0% of PS/2 at 3% false alarms. Shipped Phase B model (prescaler, MARGIN calibrated against foreign windows): 4.7% false alarms; the floor flags 94% of fast random edges on four pins and none of the PWM, WS2812 or clock windows | No OOD hardware (decided again after Phase B, Nov 2026): the prototype test flags 19% of held-out JTAG/SWD and 26% of PS/2 at 4% false alarms, or 51% and 32% at 12%, which does not earn its area. Ship "answers only when confident". With the first model the confident flag was right 99.5% of the time on known classes and fired on none of the foreign signals except WS2812 with the unused pins idle low (6%). The more accurate Phase B model fired on 95-100% of PWM and random-edge windows and on 60-68% of held-out PS/2 and JTAG/SWD windows. Training against foreign traffic cost too much accuracy in an 8-unit network (85% at the mildest useful setting), so MARGIN is instead the smallest margin that keeps known-class precision at 99% and confident foreign validation windows at 5% or fewer. Shipped: 21% of known windows confident and all right; 0-13% confident on WS2812, clocks and random edges, 3% and 0% on held-out JTAG/SWD and PS/2; but a 20 kHz PWM is still confidently called CAN, and UART, CAN and USB-LS are never confident at that MARGIN. Per-class margins (EAR_MARGIN_K, built in Phase C, Nov 2026) give each class its own: 58% of known windows confident, 99.9% right; USB-LS, I2C and PS/2 now confident on 79-100% of their windows; CAN still never and UART rarely; held-out foreign windows confident 10.5% on the confident bit and 6.7% past the floor, against 7.0% with one margin; WS2812 confident on 16% (as Manchester). EAR_MARGIN still sets all eight, so the one-margin trade-off stays available to the host. Label the floor flag "unknown" rather than "anomaly" and publish the rates |
| CMOS5L template or flow problems (new branch) | Counter does not reach GDS in week 1 | Email asic-competition@janestreet.com and the Tiny Tapeout Discord in week 1, not week 10 |
| No partner by 11 Oct | Decided 23 Sep: solo | No USB, Ear kept. The single-EM cut is not taken: both EMs are already built and verified, and they use about 9% of the core |
| Electrical unknowns on the demo board (open-drain, USB pull-ups) | | Prove on the FPGA; claim only what ran |
| The GDS job hits GitHub's 6-hour limit | Job time near 6 h. Measured on 10 Oct 2026 (PR 2): gds 3 h 26 min, precheck 2 h 52 min, each its own job | Harden locally with the same Tiny Tapeout flow (https://tinytapeout.com/guides/local-hardening/), as the organisers suggest; an 8x4 build with more logic is the likely trigger |
| Time, alongside the day job and other ventures | A missed checkpoint | Cut scope at the checkpoint, never the timeline |

Cut order, cheapest first: 1. Manchester serializer and DDR capture. 2. CRC unit. 3. Monitors 4 to 2. 4. Recorder 32 to 16 entries. 5. Ear to 3 pins, 6 pairs, hidden layer 6. 6. One shared 32-word program memory. 7. Single EM. 8. Drop the Ear; the EM, monitors and recorder are still a complete, novel entry. Never cut: the ISS, the prover, the verification stack, the FPGA proof.

## Milestones to the deadline

Submission is targeted for 12 Jan 2027, six days before the 18 Jan 2027 deadline, with a feature freeze on 20 Dec 2026; the ISS and firmware come before any RTL so the ISA is proven cheap.

| Date | Milestone | Owner | Status |
| --- | --- | --- | --- |
| 4 Oct 2026 | Counter through the CMOS5L template to GDS; logic level, SRAM macro and I/O speed questions answered; Tang Nano 20K and test devices ordered | Gautam | Input path through GDS, precheck and gate-level test on the CMOS5L flow (the early CI failures were billing on a private repo). SRAM checked (section 8). Logic level, I/O speed and ordering pending |
| 11 Oct 2026 | Partner decision; Hardcaml or Verilog decided; core clock chosen (40, 50 or 60 MHz); ISA v1 frozen (this doc) | Gautam | Solo and Verilog, decided 23 Sep. ISA v1.1 reconciled (docs/isa-decisions.md); clock and freeze pending |
| 25 Oct 2026 | ISS, assembler and disassembler; UART, SPI and I2C firmware passing on the ISS; protocol simulator emitting edge streams for training; shruti prove v0 proves the UART transmit contract with symbolic data and bit period | Gautam | ISS, assembler and firmware (UART TX/RX, SPI master, I2C master) done and tested on the ISS; shruti prove v0 proves the UART TX contract for P = 8..65,535, all bytes and arrival times, in about 0.5 s; protocol simulator done (ear/protosim.py) |
| 8 Nov 2026 | EM0 RTL passes differential tests against the ISS; first measured synthesis cell count | Gautam | Done early (23 Sep): both EMs, host SPI and pin drivers match the ISS in every register every cycle over 60 random programs; fw/uart_tx.s sends bytes out of B0; placed and routed at 28% utilisation, 50 MHz met at all corners (section 8) |
| 15 Nov 2026 | Feature extractor RTL with bit-exact reference; first Ear model trained on synthetic data, weights loading over SPI | Gautam | Bit-exact reference done (input path checked against the RTL); first model trained on simulated buses: 86.6% test accuracy for the integer model, 99.5% when confident (92.8% and 99.0% after the Phase B recipe, Nov 2026); the OOD flag failed its held-out-class check (ear/REPORT.md). Ear RTL done 24 Sep: bit-exact to the reference in cocotb (classes, flags and their timing on every window; all 72 features read back over SPI), weights loading over SPI. Placed and routed 5 Oct with the EMs: timing closes at 50 MHz at all corners (+4.24 ns slow), 69% utilisation. Evaluated 8 Oct beyond the test set (ear/evaluate.py): UARTs at 19,200 baud and slower get almost no answers, fast UARTs are called CAN, and the OOD flag misses foreign and held-out traffic; the confident flag is the signal to trust |
| 29 Nov 2026 | Checkpoint: both EMs, host SPI, monitors, recorder and Ear integrated; UART, SPI and I2C pass protocol tests and their contracts are proven; placed density under the flow's 60% target and timing met at 50 MHz, or the cut list applies (v1.0 said a cell count under 13,000, which section 8's measurements show is about half the real capacity) | Gautam | Contracts proven: UART TX (any number of frames), UART RX, SPI master, I2C master (one transaction) |
| 6 Dec 2026 | FPGA bring-up against a USB-UART adapter, SPI flash and I2C sensor; capture dataset started; Ethernet link pulses light a switch LED if the serializer is in | Gautam |  |
| 13 Dec 2026 | Formal suite closes, classifier proof included; Ear fine-tuned on FPGA captures; confusion matrix and OOD numbers recorded | Gautam | Started 8 Oct: 27 Event Machine properties proved by k-induction, each failed by a planted bug, in CI (verify/README.md); OOD numbers on simulated buses recorded (ear/REPORT.md); classifier proof, capture and recorder properties not started |
| 20 Dec 2026 | Feature freeze; low-speed USB, Ethernet frame transmit and the prover-accepted PS/2 firmware demo count only if already passing | Both |  |
| 4 Jan 2027 | Place-and-route, timing signoff at 50 MHz, gate-level simulation of key tests | Gautam |  |
| 12 Jan 2027 | Submission: README, ISA reference, verification report with bugs-per-method table, demo video | Gautam |  |
| 18 Jan 2027 | Jane Street deadline (buffer) | |  |

## Open questions for week one

Eight facts this spec assumes but has not verified; each changes a number above, so they come before any RTL.

- [ ] Maximum core clock and pin toggle rate on the CMOS5L Tiny Tapeout board: decides 50 MHz vs 24 MHz and whether low-speed USB is claimable (organisers, 9 Oct 2026: there is no target clock, so pick one that closes timing after place-and-route; CMOS5L has no silicon back yet and no characterised pad numbers, and Tiny Tapeout is checking for SG13G2 figures)
- [ ] Logic level of the board's I/O (assumed 3.3 V) and whether uio pins can be tri-stated per pin at runtime, which open-drain mode needs
- [x] SRAM macro sizes and area on CMOS5L, from the template and the ttihp0p2 SRAM example: feeds the SRAM rule in section 8 (answered 23 Sep: stay with flops, section 8)
- [x] Whether the 8x4 tile option is confirmed, and by when: decides the third EM vs 64-word memory choice (organisers, November 2026: 8x4 is confirmed for the March 2027 CMOS5L shuttle, tile sizes are final, and the template's main branch targets CMOS5L; the choice is made on the first 8x4 run)
- [x] SRAM macros on the CMOS5L shuttle (organisers, 9 Oct 2026: allowed, more than one, if they fit and pass precheck; powered on Metal4 per the walkthrough in section 8)
- [ ] Whether the dont_use clock-gate cell may be instantiated (section 8)
- [x] Which flow version the cmos5l template branch runs (LibreLane or OpenLane) and whether the GDS GitHub Action works on a fork today (LibreLane 3.1.0.dev3; the GDS, precheck and gate-level jobs pass on this repo)
- [x] Partner: who owns microarchitecture and physical design, whether they will write it in Hardcaml, and by 11 Oct (solo, Verilog, decided 23 Sep)
- [ ] Final 8 Ear classes: UART, SPI, I2C, low-speed USB, CAN, JTAG/SWD, PS/2, Manchester, or swap CAN for 1-Wire
- [ ] Name and licence: check "Shruti" for collisions with existing chips or tools; Apache-2.0 for everything, or CERN-OHL-P for the RTL

One decision with no research needed: publish a short write-up of the architecture at ISA freeze on 11 Oct to establish priority, not after the FPGA works.
