gautam1858/shruti/verify/README.md

# verify: everything that checks the design

cocotb bus models and mutation tests, the constrained-random differential harness (RTL vs ISS), SymbiYosys properties for the scheduler, capture, FIFOs, recorder and the classifier datapath, and the bugs-found-per-method report.
