gautam1858/shruti/test/test.py

# SPDX-FileCopyrightText: 2026 Gautam Ramachandra
# SPDX-License-Identifier: Apache-2.0
#
# Milestone 1 tests: the host SPI, the Event Machines against the ISS (iss/sim.py), the
# UART transmitter firmware out of a pin, and the input filter. Every test runs at RTL and
# on the gate-level netlist; the ones that look inside the design say so and run at RTL only.

import random

import cocotb

from harness import (CFG_OUT, CTRL, EM_BASE, FILTER, FLAGS, GATES, ID, P_LO, RUN_ALL, RXPORT,
                     SYNC, TXPORT, Chip)
import randprog

import fw
from fw.peers import uart_decode
from iss import Sim


async def new_chip(dut):
    chip = Chip(dut)
    await chip.start_clock()
    await chip.reset()
    return chip


# -- host interface ------------------------------------------------------------------------

@cocotb.test()
async def host_spi_registers(dut):
    chip = await new_chip(dut)
    assert await chip.read(ID, 2) == [0x53, 0x11], "ID and ISA version"
    await chip.write(EM_BASE[0] + P_LO, [0x34, 0x12])
    await chip.write(EM_BASE[1] + P_LO, [0xCD, 0xAB])
    assert await chip.read(EM_BASE[0] + P_LO, 2) == [0x34, 0x12]
    assert await chip.read(EM_BASE[1] + P_LO, 2) == [0xCD, 0xAB]
    await chip.write(EM_BASE[0] + CFG_OUT, [0x3F, 0x10])
    assert await chip.read(EM_BASE[0] + CFG_OUT, 2) == [0x3F, 0x10]
    await chip.write(SYNC, [0x5])
    await chip.write(FILTER, [0x2])
    assert await chip.read(SYNC, 2) == [0x5, 0x2]
    assert await chip.read(EM_BASE[0] + CTRL) == [0], "EMs are stopped after reset"
    assert chip.irq == 0


# -- the UART transmitter out of a pin -----------------------------------------------------

TXD = 1         # uart_tx.s drives B1: Tiny Tapeout's Pmod UART TXD, top row


async def run_uart_tx(chip, B, data):
    words = fw.load("uart_tx")
    await chip.setup_em(0, words, P=B, tx=data[:4])
    frame = 10 * B
    cycles = 40 + frame * len(data)
    start = await chip.start(0b01)
    # the rest of the bytes go in while the first ones are on the wire, one per frame
    host_tx = [(0, b) for b in data[:4]]
    for b in data[4:]:
        await chip.ticks(max(0, start + frame * (len(host_tx) - 2) - chip.k))
        await chip.write(EM_BASE[0] + TXPORT, [b])
        host_tx.append((chip.last_rise + 4 - start, b))
    await chip.ticks(start + cycles - chip.k)
    got = chip.pad_trace(start, start + cycles, pins=[TXD])
    ref = Sim([words], P=[B], host_tx=[host_tx], rx_drain=False).run(cycles)
    assert got == ref.trace, "pin B1 differs from the ISS"
    frames = uart_decode([(c, v) for c, _, v in got], 1, B, cycles)
    assert [b for _, b, _ in frames] == data and all(ok for _, _, ok in frames)
    assert (await chip.read_reg(0, FLAGS)) == 0, "no LATE, OVF or UNF"


@cocotb.test()
async def uart_tx_out_of_a_pin(dut):
    """fw/uart_tx.s on EM0 sends bytes on B1 (the Pmod UART TXD pin, uio[1]), matching the
    ISS cycle for cycle."""
    chip = await new_chip(dut)
    rng = random.Random(1)
    for B in ([16, 50] if not GATES else [16]):
        await chip.reset()
        await run_uart_tx(chip, B, [rng.randrange(256) for _ in range(6)])


# -- Event Machines against the ISS --------------------------------------------------------

def probe_em(dut, em):
    u = getattr(dut.user_project, f"u_em{em}")
    g = lambda s: int(getattr(u, s).value)
    return {
        "PC": g("pc"), "T": g("T"), "X": g("X"), "Y": g("Y"), "P": g("P"),
        "OSR": g("osr"), "OSR_COUNT": g("osr_cnt"), "ISR": g("isr"), "ISR_COUNT": g("isr_cnt"),
        "SNAPSHOT": g("snapshot"), "PIN_MODE": g("pin_mode"),
        "TO": g("f_to"), "LATE": g("f_late"), "OVF": g("f_ovf"), "UNF": g("f_unf"),
        "halted": g("halted"), "tx": g("tx_cnt"), "rx": g("rx_cnt"),
        "OUT_N": g("out_n"), "OUT_MSB": g("out_msb"), "AUTOPULL": g("autopull"),
        "IN_N": g("in_n"), "IN_MSB": g("in_msb"), "AUTOPUSH": g("autopush"),
        "txd": [g(f"txm{(g('tx_rd') + i) % 4}") for i in range(g("tx_cnt"))],
        "rxd": [rx_slot(g, (g("rx_rd") + i) % 4) for i in range(g("rx_cnt"))],
    }


def rx_slot(g, k):
    """An RX FIFO slot as the host would read it: a push writes its bytes a cycle after it
    counts them, and the pending bytes are forwarded."""
    n, idx, data = g("rxp_n"), g("rxp_idx"), g("rxp_data")
    if n and k == idx:
        return data & 0xFF
    if n == 2 and k == (idx + 1) % 4:
        return data >> 8
    return g(f"rxm{k}")


def iss_em(em):
    return {
        "PC": em.PC, "T": em.T, "X": em.X, "Y": em.Y, "P": em.P,
        "OSR": em.OSR, "OSR_COUNT": em.OSR_COUNT, "ISR": em.ISR, "ISR_COUNT": em.ISR_COUNT,
        "SNAPSHOT": em.SNAPSHOT, "PIN_MODE": em.PIN_MODE,
        "TO": int(em.TO), "LATE": int(em.LATE), "OVF": int(em.OVF), "UNF": int(em.UNF),
        "halted": int(em.halted), "tx": len(em.tx), "rx": len(em.rx),
        "OUT_N": em.OUT_N, "OUT_MSB": em.OUT_MSB, "AUTOPULL": em.AUTOPULL,
        "IN_N": em.IN_N, "IN_MSB": em.IN_MSB, "AUTOPUSH": em.AUTOPUSH,
        "txd": list(em.tx), "rxd": list(em.rx),
    }


async def differential_case(chip, rng, cycles, per_cycle):
    progs = [randprog.program(rng), randprog.program(rng)]
    Ps = [rng.choice([0, 1, 3, 5, 8, 13, 40]) for _ in range(2)]
    cfgs = [{"OUT_N": rng.choice([7, 3, 15, 0]), "OUT_MSB": rng.randrange(2),
             "AUTOPULL": rng.randrange(2), "IN_N": rng.choice([7, 3, 15, 0]),
             "IN_MSB": rng.randrange(2), "AUTOPUSH": rng.randrange(2)} for _ in range(2)]
    txs = [[rng.randrange(256) for _ in range(rng.randrange(5))] for _ in range(2)]
    stim = randprog.stimulus(rng, cycles)

    await chip.reset()
    for em in range(2):
        await chip.setup_em(em, progs[em], P=Ps[em], cfg=cfgs[em], tx=txs[em])
    probes = {}
    if per_cycle:
        dut = chip.dut

        def probe():
            probes[chip.k] = (probe_em(dut, 0), probe_em(dut, 1), int(dut.user_project.sync.value),
                              int(dut.user_project.cnt.value))
        chip.probe = probe
    start = await chip.start(0b11)
    chip.schedule(start, stim)
    # mid-run host writes: a TX FIFO byte or all four SYNC flags. A write in effect from
    # cycle w is an ISS host action at w.
    host_tx = [[(0, b) for b in t] for t in txs]
    host_sync = []
    host_rx_pop = []
    for _ in range(rng.randrange(4)):
        await chip.ticks(rng.randrange(60))
        r = rng.random()
        if r < 0.3:
            # an RX FIFO read pops each byte when its first bit is clocked
            em, nb = rng.randrange(2), rng.randrange(1, 3)
            await chip.read(EM_BASE[em] + RXPORT, nb)
            host_rx_pop += [(t + 4 - start, em) for t in chip.first_rises[2:]]
        elif r < 0.7:
            em, b = rng.randrange(2), rng.randrange(256)
            await chip.write(EM_BASE[em] + TXPORT, [b])
            host_tx[em].append((chip.last_rise + 4 - start, b))
        else:
            v = rng.randrange(16)
            await chip.write(SYNC, [v])
            host_sync += [(chip.last_rise + 4 - start, f, (v >> f) & 1) for f in range(4)]
    await chip.ticks(max(0, start + cycles - chip.k))
    await chip.write(RUN_ALL, [0])
    stop = chip.last_rise + 4                     # first cycle with both EMs stopped
    chip.probe = None
    n = stop - start                              # ISS cycles 0 .. n-1 ran on the chip

    offset = probes[start][3] if per_cycle else 0   # counter value in ISS cycle 0
    sim = Sim(progs, stimulus=stim, P=Ps, cfg=cfgs, host_tx=host_tx, host_sync=host_sync,
              host_tx_drop=True, host_rx_pop=host_rx_pop, rx_drain=False, step_every_cycle=True, counter_offset=offset)
    where = f"host_tx {host_tx} sync {host_sync} pops {host_rx_pop} P {Ps} cfg {cfgs}"
    landing = ({w for h in host_tx for w, _ in h} | {w for w, _, _ in host_sync}
               | {w for w, _ in host_rx_pop})
    if per_cycle:
        for c in range(n):
            sim.run(c + 1)
            got = probes[start + c + 1][:3]
            want = (iss_em(sim.ems[0]), iss_em(sim.ems[1]), sum(f << i for i, f in enumerate(sim.sync)))
            if c + 1 in landing:
                # the RTL register already holds a host write the ISS applies in cycle c + 1
                host = {"tx": 0, "txd": 0, "rx": 0, "rxd": 0}
                got = ({**got[0], **host}, {**got[1], **host}, 0)
                want = ({**want[0], **host}, {**want[1], **host}, 0)
            if got != want:
                for em in range(2):
                    diff = {k: (got[em][k], want[em][k]) for k in want[em] if got[em][k] != want[em][k]}
                    if diff:
                        raise AssertionError(f"cycle {c}, EM{em} (rtl, iss): {diff}; {where}")
                raise AssertionError(f"cycle {c}: SYNC rtl {got[2]} iss {want[2]}; {where}")
    else:
        sim.run(n)
    got = chip.pad_trace(start, stop)
    want = [e for e in sim.trace if e[0] < n and e[1] < 8]
    assert got == want, f"pin trace differs; first rtl/iss: {got[:4]} / {want[:4]}; {where}"
    for em in range(2):
        rx = await chip.read(EM_BASE[em] + RXPORT, len(sim.ems[em].rx)) if sim.ems[em].rx else []
        assert rx == sim.ems[em].rx, f"EM{em} RX FIFO"
    return n


@cocotb.test()
async def event_machines_match_the_iss(dut):
    """Random two-EM programs and random pin stimulus: pins, RX FIFOs and (at RTL) every
    architectural register, cycle by cycle, against the ISS."""
    chip = await new_chip(dut)
    chip.probe = None
    rng = random.Random(2026)
    cases = 6 if GATES else 60
    for _ in range(cases):
        await differential_case(chip, rng, 400, per_cycle=not GATES)


async def pull_while_full(chip, n):
    """EM0 pulls one byte at cycle n + 2 from a full TX FIFO while the host writes one more.
    Returns the cycle the write takes effect and the TX FIFO count afterwards."""
    from asm import assemble
    prog = assemble(f"SET X, {n}\nw: JMP X--, w\nPULL\nHALT")
    await chip.reset()
    await chip.setup_em(0, prog, tx=[1, 2, 3, 4])
    start = await chip.start(0b01)
    await chip.write(EM_BASE[0] + TXPORT, [9])
    w = chip.last_rise + 4 - start
    await chip.ticks(max(0, start + n + 10 - chip.k))
    return w, await chip.read_reg(0, TXPORT)


@cocotb.test()
async def tx_fifo_write_in_the_cycle_of_a_pull(dut):
    """A host byte written to a full TX FIFO is dropped, unless the EM pulls in that very
    cycle; the ISS (host_tx_drop) agrees at the cycle before, at and after the pull."""
    from asm import assemble
    chip = await new_chip(dut)
    w, _ = await pull_while_full(chip, 1000)
    counts = {}
    for n in (w - 4, w - 3, w - 2):
        w2, counts[n] = await pull_while_full(chip, n)
        assert w2 == w
        prog = assemble(f"SET X, {n}\nw: JMP X--, w\nPULL\nHALT")
        ref = Sim([prog], host_tx=[[(0, b) for b in (1, 2, 3, 4)] + [(w, 9)]], host_tx_drop=True,
                  rx_drain=False).run(n + 20)
        assert counts[n] == len(ref.ems[0].tx), f"PULL at cycle {n + 2}, write at {w}"
    assert counts[w - 3] == 4, "the write in the cycle of the pull is kept"
    assert counts[w - 2] == 3, "a write one cycle before the pull is dropped"


RX_WRAP = """
        WAIT  M0, high           ; latch the snapshot: M0 = 1, M1 = 0
        SET   X, 7
a:      IN    M0 @snap
        JMP   X--, a
        PUSH                     ; 0xFF (8-bit words)
        SHIFT in, lsb, 16
        SET   X, 7
b:      IN    M0 @snap
        JMP   X--, b
        SET   X, 7
c:      IN    M1 @snap
        JMP   X--, c
        PUSH  block              ; 0xFF, 0x00: the FIFO holds three bytes
        SET   X, 7
d:      IN    M0 @snap
        JMP   X--, d
        SET   X, 7
e:      IN    M1 @snap
        JMP   X--, e
        PUSH  block              ; waits for the host to make room, then wraps around
        HALT
"""


@cocotb.test()
async def rx_fifo_two_byte_push_wraps(dut):
    """A 16-bit PUSH whose two bytes straddle the end of the RX FIFO ring."""
    from asm import assemble
    chip = await new_chip(dut)
    chip.m = 0b1101                                  # M1 low
    prog = assemble(RX_WRAP)
    await chip.setup_em(0, prog)
    start = await chip.start(0b01)
    await chip.ticks(start + 80 - chip.k)
    first = await chip.read(EM_BASE[0] + RXPORT, 2)
    pops = [(t + 4 - start, 0) for t in chip.first_rises[2:]]
    await chip.ticks(100)
    rest = await chip.read(EM_BASE[0] + RXPORT, 3)
    end = chip.first_rises[2] + 4 - start
    ref = Sim([prog], initial={9: 0}, rx_drain=False, host_rx_pop=pops).run(end)
    assert first == ref.host_rx[0] == [0xFF, 0xFF]
    assert rest == ref.ems[0].rx == [0x00, 0xFF, 0x00]


async def push_then_read(chip, n):
    """EM0 pushes 0x07 at cycle n + 6 while the host reads the RX FIFO. Returns the cycle at
    which the host's read captures the FIFO head, and the byte it read."""
    from asm import assemble
    prog = assemble(f"""
        WAIT  M0, high
        IN    M0 @snap
        IN    M0 @snap
        IN    M0 @snap
        SET   X, {n}
    w:  JMP   X--, w
        PUSH
        HALT""")
    await chip.reset()
    await chip.setup_em(0, prog)
    start = await chip.start(0b01)
    got = await chip.read(EM_BASE[0] + RXPORT)
    # the read data is captured 3 cycles after the address byte's last SCK edge
    return chip.first_rises[2] - 8 + 3 - start, got[0]


@cocotb.test()
async def rx_fifo_read_in_the_cycle_after_a_push(dut):
    """A push writes its byte a cycle after it counts it; a host read that captures the head
    in between gets the byte by forwarding."""
    chip = await new_chip(dut)
    load, _ = await push_then_read(chip, 800)
    n = load - 7                       # the PUSH executes at n + 6 = load - 1
    load2, byte = await push_then_read(chip, n)
    assert load2 == load
    assert byte == 0x07, f"read {byte:#x}"


# -- input filter, seen through an Event Machine ---------------------------------------------

MIRROR = """
.pin src M0
.pin dst B0
top:  WAIT src, low
      SET  dst, 0
      WAIT src, high
      SET  dst, 1
      JMP  top
"""


async def mirror_edges(chip, mode, pulses):
    """Mirror M0 onto B0 with EM0 and count B0 edges for the given M0 pulse widths."""
    from asm import assemble
    await chip.reset()
    await chip.write(FILTER, [mode])
    await chip.setup_em(0, assemble(MIRROR))
    start = await chip.start(0b01)
    t, stim = 40, []
    for w in pulses:
        stim += [(t, 8, 0), (t + w, 8, 1)]
        t += w + 30
    chip.schedule(start, stim)
    await chip.ticks(start + t + 20 - chip.k)
    return len(chip.pad_trace(start, start + t + 20, pins=[0]))


@cocotb.test()
async def glitch_filter_modes(dut):
    chip = await new_chip(dut)
    # EM0 copies every low pulse on M0 that survives the filter onto B0 (two B0 edges each):
    # bypass passes a one-cycle glitch, 2-of-3 needs two cycles, 3-of-5 three
    assert await mirror_edges(chip, 0, [1]) == 2
    assert await mirror_edges(chip, 1, [1]) == 0
    assert await mirror_edges(chip, 1, [2]) == 2
    assert await mirror_edges(chip, 2, [2]) == 0
    assert await mirror_edges(chip, 2, [3, 8]) == 4


# -- the input path against its bit-exact reference (RTL only: it reads filt_d) -----------------

from ear.inpath import filter_cycles  # noqa: E402


def random_levels(rng, n):
    out, level = [], 0
    while len(out) < n:
        out += [level] * rng.choice([1, 1, 2, 2, 3, 4, 5, 6, 8, 13])
        level ^= 1
    return out[:n]


@cocotb.test(skip=GATES)
async def input_path_matches_reference_model(dut):
    chip = await new_chip(dut)
    rng = random.Random(2026)
    n = 600
    for mode in (0, 1, 2):
        await chip.reset()
        chip.ext, chip.m = 0, 0
        await chip.write(FILTER, [mode])
        await chip.ticks(10)
        u = [random_levels(rng, n) for _ in range(12)]
        base = chip.k + 1
        for k in range(n):
            for p in range(12):
                if k == 0 or u[p][k] != u[p][k - 1]:
                    chip.stim.setdefault(base + k, []).append((p, u[p][k]))
        observed = {}
        chip.probe = lambda: observed.__setitem__(chip.k, int(chip.dut.user_project.filt_d.value))
        await chip.ticks(n + 1)
        chip.probe = None
        for p in range(12):
            filt, _ = filter_cycles(u[p], mode, before=0)
            got = [(observed[base + k] >> p) & 1 for k in range(n)]
            assert got == filt, f"mode {mode}, pin {p}: first mismatch at cycle " \
                f"{next(i for i, (a, b) in enumerate(zip(got, filt)) if a != b)}"


# -- the Ear against ear/features.py and ear/mlp.py ------------------------------------------

import json  # noqa: E402
from pathlib import Path  # noqa: E402

from harness import EAR_BEST, EAR_CFG, EAR_FEATURES, EAR_MARGIN, EAR_MARGIN_K, EAR_RESULT  # noqa: E402

from ear import protosim  # noqa: E402
from ear.features import extract  # noqa: E402
from ear.inpath import filter_pins  # noqa: E402
from ear.mlp import Config, Model  # noqa: E402

EAR_DIR = Path(__file__).resolve().parents[1] / "ear"


def trained_model():
    cfg = json.loads((EAR_DIR / "weights/default.json").read_text())["config"]
    return Model.from_hex((EAR_DIR / "weights/default.hex").read_text(), Config(**cfg))


def random_model(rng, per_class=False):
    """Random weights and configuration; per_class adds random per-class margins, drawn last so
    the tests without them keep their random streams."""
    w = lambda: rng.choice([0, 0, 1, -1])
    m = Model([[w() for _ in range(72)] for _ in range(8)], [[w() for _ in range(8)] for _ in range(8)],
              Config(shift=rng.randrange(7), margin=rng.randrange(40),
                     floor=rng.randrange(-200, 200), min_edges=rng.randrange(0, 257)),
              [rng.randrange(-128, 128) for _ in range(8)])
    if per_class:
        m.cfg.margins = [rng.randrange(40) for _ in range(8)]
    return m


def ear_out(uo):
    return (uo >> 4) & 7, (uo >> 3) & 1, (uo >> 7) & 1          # pins' class, confident, ood


async def ear_case(chip, model, pad_edges, cycles, initial=(1, 1, 1, 1), prescale=1):
    """Drive pad edges (cycle, pin 0-3, level) on B0-B3 from the Ear's first cycle and check
    every classification the reference makes, at the cycle the reference says it lands: the
    confident and OOD pins show the latest window, the class pins the last window that was
    confident and not OOD (0 after reset)."""
    await chip.reset()
    chip.ext = sum(v << p for p, v in enumerate(initial)) | 0xF0
    await chip.ticks(4)
    await chip.load_ear(model, prescale=prescale)
    start = await chip.start_ear()
    chip.schedule(start, [(c + 20, p, v) for c, p, v in pad_edges if c + 20 < cycles])
    await chip.ticks(start + cycles - chip.k)
    edges = filter_pins(list(initial), [(c + 20, p, v) for c, p, v in pad_edges if c + 20 < cycles], 0)
    windows = extract(list(initial), edges, cycles, prescale=prescale)
    shown = ear_out(chip.outs[start])
    assert shown[0] == 0, "class pins are 0 after reset"
    pins = 0
    checked = 0
    for w in windows:
        at = start + w.end + 649                  # first cycle showing this window's result
        if at >= start + cycles:
            break
        r = model.infer(w.features, w.edges)
        chip.ear_held = getattr(chip, "ear_held", 0) + (Model.pins_class(pins, r) != r.cls)
        pins = Model.pins_class(pins, r)
        want = (pins, int(r.confident), int(r.ood))
        before = ear_out(chip.outs[at - 1])
        assert before == shown, f"window at {w.start}: outputs changed before the result was due"
        assert ear_out(chip.outs[at]) == want, \
            f"window {w.start}..{w.end}: rtl {ear_out(chip.outs[at])} reference {want} logits {r.logits}"
        # nothing else moves until the next window's result
        shown = want
        checked += 1
    return checked


def pins_of(cap, rng):
    assign = protosim.random_assignment(cap, rng)
    init, edges = protosim.to_pins(cap, assign)
    return init, edges


@cocotb.test()
async def ear_classifies_protocol_traffic_like_the_reference(dut):
    """The trained weights on simulated UART, SPI and I2C traffic: every window's class,
    confidence and OOD flags, and the cycle they change, match the Python reference."""
    chip = await new_chip(dut)
    rng = random.Random(5)
    model = trained_model()
    total = 0
    cases = [(protosim.uart, dict(period=20)), (protosim.spi, dict(half=6)), (protosim.i2c, dict(half=12))]
    for gen, kw in (cases if not GATES else cases[1:2]):     # gate level: SPI, 5 windows
        cap = gen(rng, duration=14000, **kw)
        init, edges = pins_of(cap, rng)
        total += await ear_case(chip, model, edges, 14000, init)
    assert total >= (6 if not GATES else 3), f"only {total} windows checked"


@cocotb.test()
async def ear_matches_reference_with_random_weights(dut):
    """Random weights, thresholds and configuration on random edges, including simultaneous
    edges on several pins and bursts that fill the histogram's top bin."""
    chip = await new_chip(dut)
    rng = random.Random(9)
    total = 0
    for _ in range(4 if not GATES else 1):
        model = random_model(rng, per_class=True)
        edges, level, t = [], [1, 1, 1, 1], 0
        while t < 9000:
            t += rng.choice([1, 1, 2, 3, 5, 8, 13, 40, 90, 300])
            for p in range(4):
                if rng.random() < 0.4:
                    level[p] ^= 1
                    edges.append((t, p, level[p]))
        total += await ear_case(chip, model, edges, 9000)
    assert total >= (4 if not GATES else 1)
    if not GATES:
        assert chip.ear_held > 0, "no window kept an earlier class on the pins" 


def random_pad_edges(rng, cycles, scale=1, gaps=(1, 1, 2, 3, 5, 8, 13, 40, 90, 300)):
    """Random edges on pins 0-3, gaps in units of `scale` cycles plus a random part of one."""
    edges, level, t = [], [1, 1, 1, 1], 0
    while t < cycles:
        t += scale * rng.choice(gaps) + rng.randrange(scale)
        for p in range(4):
            if rng.random() < 0.4:
                level[p] ^= 1
                edges.append((t, p, level[p]))
    return edges


@cocotb.test()
async def ear_prescaler_matches_reference(dut):
    """EAR_CFG at 4, 16 and 64 cycles per tick: random weights on random edges spread over
    ticks; every window's result and the cycle it lands match the reference."""
    chip = await new_chip(dut)
    rng = random.Random(21)
    total = 0
    for P in ((4, 16, 64) if not GATES else (16,)):
        cycles = 3000 * P + 4000                  # three or more windows of 256 edges
        edges = random_pad_edges(rng, cycles, P, gaps=(1, 1, 2, 3, 5, 8, 13))
        total += await ear_case(chip, random_model(rng), edges, cycles, prescale=P)
    assert total >= (3 if not GATES else 1)
    await chip.write(EAR_CFG, [2])
    assert (await chip.read(EAR_CFG))[0] == 2, "EAR_CFG reads back"


@cocotb.test()
async def ear_per_class_margins_match_reference(dut):
    """Per-class margins at the windows' own gaps: a class's margin is the gap of the first
    window the reference calls that class, plus one for every other class in the order they
    appear, and 255 for classes no window is called. A window's confidence then depends on
    which class's margin the hardware compares, to the last unit."""
    chip = await new_chip(dut)
    rng = random.Random(33)
    total = 0
    for _ in range(3 if not GATES else 1):
        cycles = 30000
        for _ in range(50):                      # random weights often call one class only
            model = random_model(rng)
            pad = random_pad_edges(rng, cycles)
            edges = filter_pins([1] * 4, [(c + 20, p, v) for c, p, v in pad if c + 20 < cycles], 0)
            gaps = {}
            for w in extract([1] * 4, edges, cycles):
                r = model.infer(w.features, w.edges)
                top = sorted(r.logits)
                gaps.setdefault(r.cls, []).append(top[-1] - top[-2])
            if len(gaps) >= 2:
                break
        order = list(gaps)                       # classes in the order windows call them
        model.cfg.margins = [min(255, gaps[k][0] + (order.index(k) % 2)) if k in gaps else 255
                             for k in range(8)]
        assert len(order) >= 2, "the windows should call at least two classes"
        conf = [g >= model.cfg.margins[k] for k, gs in gaps.items() for g in gs]
        assert any(conf) and not all(conf), "margins should split the windows"
        total += await ear_case(chip, model, pad, cycles)
    assert total >= (6 if not GATES else 2)

@cocotb.test()
async def ear_margin_registers(dut):
    """EAR_MARGIN sets all eight per-class margins, as a host written for one margin expects;
    EAR_MARGIN_K sets one class's; both read back."""
    chip = await new_chip(dut)
    assert await chip.read(EAR_MARGIN_K, 8) == [8] * 8, "reset: every margin 8"
    await chip.write(EAR_MARGIN, [77])
    assert await chip.read(EAR_MARGIN_K, 8) == [77] * 8, "EAR_MARGIN sets every class"
    want = [3, 250, 0, 41, 17, 99, 128, 6]
    await chip.write(EAR_MARGIN_K, want)
    assert await chip.read(EAR_MARGIN_K, 8) == want
    assert (await chip.read(EAR_MARGIN))[0] == want[0], "EAR_MARGIN reads class 0's"


@cocotb.test(skip=GATES)
async def ear_prescaled_window_closes_after_65536_ticks(dut):
    """Sparse edges at 4 cycles per tick: the window closes after 262,144 cycles."""
    chip = await new_chip(dut)
    rng = random.Random(4)
    edges = [(100 + 2400 * i, i % 4, (i // 4 + 1) % 2) for i in range(110)]
    assert await ear_case(chip, random_model(rng), edges, 4 * 65536 + 1000, prescale=4) == 1


@cocotb.test(skip=GATES)
async def ear_window_closes_after_65536_cycles(dut):
    """Sparse edges: the window closes on time, not on its edge count."""
    chip = await new_chip(dut)
    rng = random.Random(3)
    edges = [(100 + 600 * i, i % 4, (i // 4 + 1) % 2) for i in range(120)]
    assert await ear_case(chip, random_model(rng), edges, 67000) == 1


@cocotb.test()
async def ear_features_read_over_spi_in_hold_mode(dut):
    """With HOLD set the Ear stops after its first window; the host reads the 72 features
    and the best logit, which match the reference."""
    chip = await new_chip(dut)
    rng = random.Random(4)
    model = trained_model()
    cap = protosim.spi(rng, duration=6000, half=5)
    init, pad = pins_of(cap, rng)
    chip.ext = sum(v << p for p, v in enumerate(init)) | 0xF0
    await chip.ticks(4)
    await chip.load_ear(model)
    start = await chip.start_ear(hold=True)
    pad = [(c + 20, p, v) for c, p, v in pad if c + 20 < 6000]
    chip.schedule(start, pad)
    await chip.ticks(start + 6000 - chip.k)
    w = extract(list(init), filter_pins(list(init), pad, 0), 6000)[0]
    assert (await chip.read(0xB0))[0] & 0x8, "held after the first window"
    await chip.write(EAR_FEATURES, [0])
    assert await chip.read(EAR_FEATURES, 72) == w.features
    r = model.infer(w.features, w.edges)
    res, lo, hi = await chip.read(EAR_RESULT, 3)
    assert res == 0x80 | r.ood << 4 | r.confident << 3 | r.cls
    assert (lo | hi << 8) - ((hi >> 7) << 16) == max(r.logits)


def window_stimulus(rng, style, n=300):
    """Pad edges for one window. 'twins' drives pins in identical pairs; 'delayed' makes pin 1
    a copy of pin 0 two cycles later (equal rank keys, asymmetric pair features) and pin 3
    high for all but one cycle (the divider's boundary); 'slowfast' makes intervals shrink so
    the histogram merges; 'burst' mixes gaps from 1 cycle to 900."""
    if style == "delayed":
        edges, level, t = [], 1, 0
        for i in range(n):
            t += rng.choice([3, 4, 6, 9, 15])
            level ^= 1
            edges += [(t, 0, level), (t + 2, 1, level), (t + 7, 2, level)]
        edges += [(t // 2, 3, 0), (t // 2 + 1, 3, 1)]
        return sorted(edges)
    edges, level, t = [], [1, 1, 1, 1], 0
    gaps = {"twins": [2, 3, 5, 9, 17], "slowfast": None, "burst": [1, 1, 2, 6, 30, 200, 900]}[style]
    for i in range(n):
        if style == "slowfast":
            t += max(1, int(2000 * (0.5 ** (i / 12))) + rng.randrange(3))
        else:
            t += rng.choice(gaps)
        if style == "twins":
            for pair in ((0, 1), (2, 3)):
                if rng.random() < 0.5:
                    for p in pair:
                        level[p] ^= 1
                        edges.append((t, p, level[p]))
        else:
            for p in range(4):
                if rng.random() < 0.45:
                    level[p] ^= 1
                    edges.append((t, p, level[p]))
    return edges


def divider_hits_boundary(h, L):
    """True if restoring division of 64 * h by L passes a remainder of exactly L - 1."""
    r = h
    for _ in range(7):
        if r == L - 1:
            return True
        r = (r - L if r >= L else r) << 1
    return False


def tune_pin3(level, pad, corner):
    """Move pin 3's low pulse to a divider corner:
    'rem' - the division passes a remainder of exactly L - 1 (needs an odd length L);
    'div-', 'div+' - the quotient changes if the divisor is one less, or one more;
    'half' - high time L / 2 with L even, where the remainder lands on exactly L."""
    base = [e for e in pad if e[1] != 3]

    def length(b):
        trial = sorted(b + [(420, 3, 0), (421, 3, 1)])
        return extract(level, filter_pins(level, trial, 0), 400_000)[0].length

    L = length(base)
    want_odd = {"rem": 1, "half": 0}.get(corner)
    if want_odd is not None and L % 2 != want_odd:   # move the closing edge by one cycle
        base = [(c + 1 if c > 430 else c, p, v) for c, p, v in base]
        L = length(base)
        assert L % 2 == want_odd
    if corner == "half":
        return sorted(base + [(420, 3, 0), (420 + L - L // 2, 3, 1)])
    for h in range(L // 2, L - 200):
        q = 64 * h // L
        ok = {"rem": lambda: divider_hits_boundary(h, L),
              "div-": lambda: q != 64 * h // (L - 1),
              "div+": lambda: q != 64 * h // (L + 1)}[corner]()
        if ok and q < 63:
            return sorted(base + [(420, 3, 0), (420 + L - h, 3, 1)])
    raise AssertionError(f"no divider corner '{corner}' for window length {L}")


@cocotb.test()
async def ear_features_match_window_by_window(dut):
    """HOLD after every window, read all 72 features and the result over SPI, compare with
    the reference, release, repeat: rank ties, histogram merges, dividers and bursts."""
    chip = await new_chip(dut)
    rng = random.Random(11)
    model = random_model(rng)
    await chip.load_ear(model)
    styles = ["twins", "delayed", "slowfast", "delayed", "burst", "delayed", "twins", "delayed"]
    first, corners = True, ["rem", "div-", "half", "div+"]
    for style in (styles if not GATES else styles[:4]):     # gate level: rem and div- only
        level = [(chip.ext >> p) & 1 for p in range(4)]
        if first:
            start = await chip.start_ear(hold=True)
            first = False
        else:
            await chip.write(0xB0, [1])                     # release: a new window starts
            start = chip.last_rise + 5                      # after one cycle clearing the old one
            await chip.write(0xB0, [3])                     # and hold again after it
        pad = [(c + 400, p, v) for c, p, v in window_stimulus(rng, style)]
        if style == "delayed":
            assert level[3] == 1, "pin 3 idles high before a delayed window"
            pad = tune_pin3(level, pad, corners.pop(0))
        chip.schedule(start, pad)
        w = extract(level, filter_pins(level, pad, 0), 400_000)[0]
        await chip.ticks(start + w.end + 700 - chip.k)
        assert (await chip.read(0xB0))[0] & 0x8, f"{style}: held"
        await chip.write(EAR_FEATURES, [0])
        got = await chip.read(EAR_FEATURES, 72)
        assert got == w.features, f"{style}: first difference at feature " \
            f"{next(i for i, (a, b) in enumerate(zip(got, w.features)) if a != b)}"
        r = model.infer(w.features, w.edges)
        res, lo, hi = await chip.read(EAR_RESULT, 3)
        assert res == 0x80 | r.ood << 4 | r.confident << 3 | r.cls, style
        assert (lo | hi << 8) - ((hi >> 7) << 16) == max(r.logits), style
        # let this window's stimulus run out, so the next window starts from steady pads
        await chip.ticks(max(0, start + pad[-1][0] + 10 - chip.k))
