gautam1858/shruti/(commit log)

2026-09-23 Shruti: architecture spec v1.0, ISA draft, milestone-0 RTL and tests
    Event-native protocol emulator for the Jane Street protocol emulator ASIC
    competition (Tiny Tapeout, IHP 130nm CMOS5L, 6x4 tiles).
    - docs/architecture-spec.md: full v1.0 architecture (Event Machines,
    Watch, the Ear, proof-carrying firmware, area budget, verification,
    milestones)
    - isa/isa.yaml: instruction set as data, single source of truth
    - src/project.v: milestone 0, synchronisers, selectable glitch filter
    (bypass, 2-of-3, 3-of-5 majority) and per-pin edge strobes
    - test/test.py: cocotb tests for the filter and edge detector
    - info.yaml, docs/info.md: Tiny Tapeout metadata and datasheet
    [isa.yaml, project.v, tb.v, test.py]
2026-09-23 ISA v1.1: reconcile isa.yaml with the spec's ISA section
    The v1.0 draft disagreed with the spec in 18 places; docs/isa-decisions.md
    lists each one and its resolution. Main changes:
    - one 6-bit delay format for OUT@ and IN@, no prescale
    - JMP is cond 3 + pin 4 + target 5, reaching all 12 pins; flag conditions
    are always, TO, LATE, TXE and OSR-not-empty
    - per-EM 16-bit bit-period register P and an ADDT P[/2|/4|/8] form
    - ADDT now is T := max(T, counter + d) with a wrap guard
    - explicit timing model and a sticky LATE flag
    - HALT at opcode 0, WAIT on levels, an explicit snapshot bit for IN
    - SHIFT is configuration; OUT with value OSR consumes one bit
    - corrected 12-word UART transmit example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
    [isa.yaml]
2026-09-23 ISS: decoder generated from isa.yaml and event-driven simulator
    iss/isa.py builds the decode and encode tables from isa/isa.yaml.
    isa.yaml gains a variants map for SET's shared operand bits (metadata only,
    no encoding change).
    iss/sim.py models one or two Event Machines with the shared counter, input
    synchronisation and edge capture, the pin snapshot, two scheduler slots,
    4-deep FIFOs, SYNC flags and push-pull/open-drain pin drive. It skips idle
    cycles; a step-every-cycle reference mode is checked against it.
    [isa.yaml]
2026-09-23 ISS: tests for every instruction and the scheduler rules
    Covers HALT and illegal operands, WAIT modes, timeouts and snapshot, OUT
    timing, OSR consumption and autopull, the two-slot blocking rule, the late
    OUT and IN cases, IN sampling and autopush, ADDT now with counter wrap and
    long idle, ADDT P, SHIFT, PUSH/PULL, SET pin modes, JMP conditions and SYNC.
2026-09-23 UART TX verified on the ISS; spec milestone status
    The 12-word transmit program produces a cycle-exact pin trace for 256
    random (byte, B) pairs with B from 8 to 65,535, back-to-back frames down to
    B = 4, and 300 baud with three ADDT P steps per bit. The spec's UART note
    and the milestone table now record this.
2026-09-23 Assembler and disassembler
    asm/ turns the spec's text syntax into 16-bit words and back, with labels,
    .pin/.equ/.word directives and errors reported with line numbers. Pin names
    move into isa.yaml (pin_names) so the assembler takes them from the ISA.
    Round trips are checked over every instruction form and all 65,536 words.
    [isa.yaml]
2026-09-23 Firmware: UART TX/RX, SPI master, I2C master with peer models
    Four Event Machine programs in fw/, each tested on the ISS against a Python
    model of the peer device: UART TX (12 words) and RX (17), SPI master mode 0
    (19) and I2C master write with ACK check, clock stretching and STOP (32).
    Measured limits at 50 MHz: UART TX B >= 4, UART RX B >= 9, SPI P >= 5.
    The LATE flag caught an SPI bug (two OUTs at T need ADDT 3, now), and the
    I2C tests caught level WAITs matching a pin's stale level while scheduled
    outputs are still in flight; the program waits on edges.
    isa.yaml now states the reset state, and the host may write CFG before
    start (the ISS gains a cfg argument). The spec's claim that eac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
    [isa.yaml, test_firmware.py]
2026-09-23 Prover v0: symbolic execution with Z3 and ISS-confirmed counterexamples
    prove/ executes Event Machine programs with the bit period, data bytes and
    their arrival times symbolic, and checks the contract beside the program
    (fw/uart_tx.contract.yaml) with Z3. LATE is a hard obligation, and every T
    write must stay within 2^23 cycles of the counter so unbounded time matches
    the 24-bit hardware.
    The UART TX contract is proved for P = 8..65,535, every byte and every
    arrival time, in about 0.5 s. Five broken variants each give a
    counterexample that the concrete ISS reproduces. The symbolic executor is
    checked against the ISS on random concrete values.
    python -m shruti prove <program.s> [--min-P] is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
2026-09-23 SPI slave firmware (mode 0), tested against a master model and EM to EM
    fw/spi_slave.s is 18 words. It releases MISO while deselected, reads MOSI
    from the pin snapshot taken at each SCK rising edge, and pushes each byte
    to the RX FIFO. Tests run it against a Python mode-0 master and against
    fw/spi_master.s on the other EM, wired together.
    Measured limits: SCK phases of at least 4 cycles and 5 cycles from CS to
    the first rise; the EM-to-EM pairing needs P >= 9 and misreads silently at
    P = 8.
2026-09-23 Spec: area table with the ISA v1.1 additions; firmware limits in headers
    The area table gains a row for the ISA v1.1 additions (about 66 flops and
    300 cells for both EMs), bringing the estimate to 10,900 cells and ~24%
    headroom. The state-bit figure in the text now matches the table (about
    5,000, not 5,400).
    uart_rx.s states its measured speed limit, and i2c_master.s states that
    the host must flush the TX FIFO after a NACK. requirements.txt lists the
    Python toolchain dependencies.
2026-09-23 Protocol simulator for Ear training data
    ear/protosim.py generates edge streams at the 50 MHz core clock for the
    Ear's eight classes: UART, SPI (modes 0-3), I2C (with clock stretching),
    low-speed USB (NRZI, bit stuffing, keep-alive EOPs), CAN 2.0A (real CRC,
    bit stuffing), JTAG and SWD, PS/2 and Manchester (single-ended or pair).
    Speeds, framing options, gaps and data are random; perturb() adds timing
    jitter and short glitches, and to_pins() maps a bus onto the four
    monitored pins in a random order.
    Every generator is tested by decoding its stream back to the payload it
    encoded. Pure Python, so the cocotb tests can use it too.
2026-09-23 Ear reference: input path, feature extractor and ternary classifier
    ear/inpath.py models the synchroniser, glitch filter and edge detector of
    src/project.v register by register; a new cocotb test checks it against the
    RTL cycle by cycle in all three filter modes. ear/features.py computes the
    72 features per window and ear/mlp.py the ternary classifier and the
    1,280-bit weight chain. ear/SPEC.md is the bit-exact definition the RTL
    must match.
    The spec left some things open or inconsistent, now resolved and recorded:
    the histogram bins against a running minimum and shifts when it drops;
    'longest in-burst interval' is defined; the classifier takes one weight per
    cycle into one accumulator (648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
    [test.py]
2026-09-23 Prover: UART TX proved for any number of frames; forking executor
    The symbolic executor is rebuilt around an explicit machine state so it can
    fork on branches that depend on symbolic inputs, keep only paths whose
    condition is satisfiable, take input waveforms with symbolic edges, and
    start from an abstract state.
    prove_unbounded() proves a contract for an unbounded stream by induction
    over a loop head named in the contract, with an invariant on T, the
    pending slots and the current cycle. For fw/uart_tx.s the base case and
    the step hold for P = 8..65,535, all bytes and arrival times, in about
    0.2 s. Broken variants and a wrong invariant are rejected, and each check
    first confirms its assumpt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
2026-09-23 Prover: UART receiver and SPI master contracts
    Receiver contracts (prove/reactive.py) describe the peer symbolically: 8N1
    frames with symbolic bytes, start times and bounded edge jitter. The
    executor forks on every input-dependent branch, keeps feasible paths, and
    stops at the first path that violates the contract; the counterexample is
    replayed on the ISS. fw/uart_rx.s is proved for P = 16..65,535 with jitter
    up to P/16, and from P = 9 without; P = 8 fails, as on the ISS.
    SPI master contracts (prove/spi.py) leave MISO samples symbolic and tie
    them afterwards to a slave model driven by the program's own CS and SCK
    edges. fw/spi_master.s is proved for P = 5..65,535 (timing, MOSI data,
    MISO d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
2026-09-23 Ear: sorted pins, 6-bit features, thresholds; first trained model
    The feature extractor presents the four pins sorted by activity, so the
    features do not depend on the wiring, and every feature is 6 bits (edge
    counts and time-high fractions drop two bits). The classifier gains an
    8-bit threshold per hidden unit; the weight chain is now 1,344 bits.
    ear/SPEC.md records each change and why.
    ear/dataset.py and ear/train.py build training data from the protocol
    simulator and train the ternary network with quantisation-aware training.
    'python -m shruti train' writes ear/weights/default.{hex,json} and
    ear/REPORT.md. On held-out simulated captures the integer model reaches
    86.6% (99.5% when confide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
2026-09-23 Prover: I2C master contract with a symbolic slave
    prove/i2c.py proves one write transaction of fw/i2c_master.s against a
    slave that ACKs or NACKs each byte, may hold SCL low after every ACK and
    answers 1 or 2 cycles after an edge: the START, SCL low and high phases of
    at least P with stretching included, SDA stable and correct while SCL is
    high, the ACK/NACK handling and NACK flag, and the STOP. P = 65..2,000,
    10 paths, about 25 s.
    The executor gains open-drain lines, input signals rebuilt from the
    program's own drives plus a peer, a WAIT that picks the earliest matching
    edge from an unordered set, and non-blocking PULL that forks on arrival.
    A WAIT may consider only recent edges, but must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
2026-09-23 ISS: host models for the chip's SPI port
    Sim(host_tx_drop=True) loses a byte written to a full TX FIFO instead of
    holding it until there is room, which is what the chip's SPI port does.
    Sim(host_rx_pop=[(cycle, em)]) reads one RX byte at a time, for tests that
    drain the FIFO mid-run. Both are off by default.
2026-09-23 Event Machines, host SPI and pin drivers in Verilog
    src/shruti_em.v implements ISA v1.1 for one Event Machine, cycle-exact
    against the ISS: decode, T arithmetic with a single subtractor, the two
    scheduler slots, OSR/ISR with autopull and autopush, the 4-byte TX and RX
    FIFOs, flags and blocking. src/project.v puts two of them behind the
    12-pin input path and the 24-bit counter, with flop program memory, the
    pin drivers (EM1 wins a same-cycle conflict), the SYNC flags and the host
    register map. src/shruti_spi.v is the host SPI slave (mode 0, SCK up to
    core clock / 8). docs/host-interface.md describes the protocol, the
    register map and its timing.
    The cocotb tests drive the chip through the ho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
2026-09-23 Spec: Verilog and solo, SRAM check, first synthesis numbers
    Records the 23 Sep decisions (RTL in Verilog, solo) and applies the
    no-partner fallback: no USB, Ear kept; the single-EM cut is not taken
    because both EMs are built, verified and small.
    Section 8 gains the SRAM check and the first measured synthesis. SRAM
    macros are available on CMOS5L, but the rule's one-macro-for-everything
    premise cannot serve two EMs fetching every cycle; per-EM macros would
    save about 5 to 6% of the core, which is not needed, so program memory
    stays in flops. The design so far is 10,090 cells, about 20% of the
    0.92 mm2 core, with the blocks about 65% over their cell estimates; the
    1,000-cells-per-tile budget i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
2026-09-23 Event Machine: registered fetch and a T - counter register
    The first place-and-route run met 50 MHz at the typical corner (+4.3 ns)
    but not at the slow corner (1.08 V, 125 C): -5.0 ns worst slack over 247
    endpoints, all in the EM execute paths. The worst ran from the program
    counter through the 32:1 program memory read, decode, two 24-bit adders
    in series and the ISR shift into the RX FIFO.
    The instruction now sits in a register loaded from one of two parallel
    reads, pc + 1 or the jump target, so the memory read is off the execute
    path. dT = T - counter is kept in a register and stepped every cycle, so
    each time comparison is one adder after a flop. No ISA-visible change:
    the cocotb suite s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
2026-09-23 Input path: register the filter output
    The second place-and-route run left 108 slow-corner endpoints failing by
    up to 2.3 ns, every one starting at the filter mode register: the filter
    mux and majority logic, and their high fanout into both EMs, sat in front
    of the execute logic.
    The filter output is now computed one cycle ahead from the earlier
    pipeline stages and registered, so the EMs read the filtered pins from
    flip-flops. The values are cycle-for-cycle the same (the bit-exact test
    against ear/inpath.py and the ISS differential tests pass unchanged), so
    the input latency in the ISA timing model does not move. hist4 is no
    longer needed.
    [project.v]
2026-09-24 Spec: place-and-route results, 50 MHz met at all corners
    The third GDS run of the Event Machine RTL closes 50 MHz timing at the
    slow, typical and fast corners (+0.06, +7.4, +11.2 ns setup slack; no
    hold violations) at 28% utilisation with no DRC or antenna violations.
    Section 8, the milestone table, the README and the verification log
    record it, with the thin slow-corner margin flagged.
2026-09-24 The Ear in RTL, bit-exact to the Python reference
    src/shruti_ear.v implements ear/SPEC.md:
    - windows of 256 edges or 65,536 cycles on 4 host-selected pins;
    - per-pin interval codes and the histogram against a running minimum;
    - in-burst longest interval, edge and time-high counts, and the 24 pair
    counters;
    - a 648-cycle pause: four restoring dividers (7 cycles), the canonical
    rank (1 cycle), then one ternary weight per cycle into one 16-bit
    accumulator, with the argmax folded into layer 2.
    The 640 weights form a ring that turns once per inference; the host
    loads them through a port while the Ear is disabled. HOLD stops after a
    window so the host can read the 72 features over SPI with n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
2026-09-24 Ear: histogram update starts from flip-flops
    The first place-and-route run with the Ear missed 50 MHz at the slow
    corner by 5.0 ns, the worst paths running from the interval counter
    through its log2 code, the compare with the running minimum and the
    histogram shift into the saturating add.
    The code of each pin's interval counter, the compares against the
    minimum and the shortest and longest codes, and the shift distance are
    now computed from the next-cycle state and registered, so the update
    reads them from flip-flops. They always equal the old combinational
    values, so the features do not change: the Ear tests and the planted
    histogram bugs give the same results, and the gate-level suite pa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
    [shruti_ear.v]
2026-10-04 Event Machine: decode the time operand at fetch
    The last place-and-route run, at 64% density, missed 50 MHz at the slow
    corner by up to 7.6 ns, all in Event Machine paths: from the instruction
    through the operand decode (d, 2^n, P >> s), a 24-bit ripple add of
    T - counter + operand, the compares, and the RX FIFO write.
    - The operand of the next word is decoded when it is fetched, using P as
    it will be in the next cycle, and registered with the instruction
    together with its negation.
    - "The target is now" and "the target is next cycle" become equalities
    between registers; the future test needs only the sign of a
    carry-select add.
    - An RX push counts its bytes in its own cycle (so the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
    [shruti_em.v, test.py]
2026-10-04 Ear: pipelined pause schedule, same 648 cycles
    The pause now runs: load the dividers (cycle 0), radix-4 division (1-3),
    rank (4), then a fetch stage that registers each multiply's input a cycle
    ahead (5-644), the multiply (6-645), the argmax on a registered output
    (the cycle after each output), and the flags (647). The total, and so
    every window boundary and the cycle the result lands, is unchanged; all
    Ear tests pass bit-exact.
    The histogram's suffix sums use a parallel prefix with one saturation at
    the end instead of seven saturating adds in series. The longest path
    drops from 105 to 51 gate levels. The "pin always high" divider case
    proved redundant (a planted removal was equivalent) and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
2026-10-04 Spec: SRAM and clock gating checked on CMOS5L; mutation results
    SRAM revisited for the Ear weights: on this shuttle the macro cannot be
    powered within the rules. The precheck forbids TopMetal1 in projects,
    and the macro's Metal4 power pins can only be strapped with TopMetal1.
    The library's clock-gate cell is marked dont_use. Both go to the open
    questions for Tiny Tapeout; area comes from the design meanwhile.
    The verification log adds the planted bugs for the Event Machine and Ear
    restructures.
2026-10-04 Event Machine: keep the reset pin off the operand path
    The first place-and-route run with the Ear missed the slow corner only on
    paths from rst_n: the operand precompute forced P to zero during reset,
    putting the pin in front of the program-memory read and operand adder.
    The term was redundant, since run is 0 in the first cycle after reset and
    that cycle reloads the operand from the cleared P. Record the run's
    numbers in the spec.
    [shruti_em.v]
2026-10-04 Event Machine: reload the time operand on stop only, not on reset
    The second place-and-route run still failed the slow corner only on
    paths from rst_n. Synthesis shares one negator between the jump and
    sequential operands behind a multiplexer, and the reload condition
    "reset or stopped" was in its select, so the reset pin and its fanout
    tree fed the 24-bit subtract. run is cleared by reset, so reloading on
    !run alone covers reset one cycle in. The longest path from rst_n to a
    flop in the synthesised netlist drops from 22 cell levels to 8.
    [shruti_em.v]
2026-10-05 Event Machine: keep both fetch reads live, compare without negating
    The third place-and-route run failed the slow corner on 23 endpoints in
    one EM. Synthesis had merged the two program-memory reads into one port
    behind an address mux selected by done/jump, and the two operand
    shifters into one. Selecting between the jump and sequential words with
    an AND-OR keeps both reads live, so nothing is shared.
    The negated operand is replaced by testing dT + d == 0 and dT + d == 1
    bit by bit without carry propagation, which removes a 24-bit negator
    and 46 flops.
    [shruti_em.v]
2026-10-31 Phase A and firmware: signoff gate, formal properties, Ear evaluation, SPI modes 0-3, I2C 100/400 kHz and target, UART baud rates, Pmod pinouts
    - CI signoff gate on the post-route metrics (verify/signoff.py): fails
    on negative slack, DRC, antenna or LVS errors.
    - 27 SymbiYosys properties of the Event Machine, proved by k-induction;
    31 planted bugs, each caught (verify/).
    - Ear evaluation beyond the test set (ear/evaluate.py, ear/REPORT.md).
    - README and spec: what is built and tested kept apart from what is
    planned, with dated status notes.
    - Assembler: conditional assembly, .define and -D overrides.
    - SPI master and slave in modes 0-3; the master proved in each mode.
    - I2C master at 1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
2026-11-09 Ear: exact search on the integer model, 92.8% on simulated buses
    Gradient training with ternary weights stalled well short of what the
    network can fit: the integer models reached only 84-90% on their own
    training data, against 97.8% for a float network of the same size,
    and restarts varied from 82.5% to 88.6% test accuracy and 19% to 82%
    UART recall. Each restart now ends with an exact search (refine) on
    the integer model as ear/mlp.py defines it: every weight and threshold
    is tried in turn and a change kept only if it lowers the class-
    balanced cross-entropy of the integer logits on the training set. The
    restart with the best balanced validation accuracy is kept, MARGIN is
    the smallest marg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
2026-11-09 Tiny Tapeout: 8x4 tiles and the ttihp27a flow
    The organisers have confirmed 8x4 tiles for the March 2027 CMOS5L
    shuttle, with final tile sizes, and the Tiny Tapeout IHP template's
    main branch now targets CMOS5L with its actions pinned at ttihp27a.
    info.yaml asks for 8x4 (1,724.2 x 710.6 um, 34% more than 6x4) and the
    workflows move from the ihp-cmos5l branch of the GDS action to the
    ttihp27a tag; src/config.json already matches the template. The design
    is unchanged: this run measures it at 8x4, and the extra area (a third
    EM, 64-word program memory or full-size Watch) is chosen from it.
2026-11-09 Ear: class pins hold the last confident answer
    uo_out[6:4] now show the class of the last window that was confident
    and not out-of-distribution (0 after reset), so LEDs on them hold an
    answer instead of changing with every window. The confident and OOD
    pins and EAR_RESULT still describe the latest window, so the register
    map is unchanged.
    Model.pins_class in ear/mlp.py is the reference; the cocotb Ear tests
    check the pins against it at the cycle each result lands, and assert
    that at least one window kept an earlier class. Wiring the pins back
    to the latest class fails both Ear class tests.
2026-11-09 Ear: timebase prescaler (EAR_CFG)
    A window closed after 65,536 cycles (1.3 ms), so slow buses got a
    handful of edges per window and no answer: a 9,600-baud UART about 6.
    EAR_CFG (0xC8, bits 1:0) now sets a tick of 1, 4, 16 or 64 cycles, and
    every time inside a window counts ticks: intervals, the 4-tick near
    window, the 65,536-tick limit and time-high. Ticks start at the
    window's first cycle; edges are still filtered and counted every
    cycle, and the 648-cycle pause is unchanged. At 1 cycle per tick the
    Ear is exactly as before.
    ear/features.py is the reference (ear/SPEC.md has the definition): a
    bus slowed by P at prescale P gives the same window as the original at
    1. The RTL adds a 6-bit co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
2026-11-09 Ear: train and evaluate at the prescaler a host would pick
    Each capture is now cut at the prescaler a host would choose: the
    smallest of 1, 4, 16 and 64 cycles per tick at which the first window
    closes on its edge count (ear/dataset.py, auto_prescale and
    auto_windows). Generators are deterministic per seed, so a slow bus is
    regenerated longer at a bigger prescaler and keeps the same traffic.
    The evaluation's coverage and probe tables use the same rule and show
    the prescaler chosen.
    Slow buses are now answered: a 2,400-baud UART on 96% of windows (0%
    before) and 92% of those right; PS/2 on 100% (34-39%), 99-100% right.
    Test accuracy is 94.4% (92.8%), UART recall 83% (75%).
    MARGIN is now als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
2026-11-09 Docs: no out-of-distribution hardware; Phase B findings and planted bugs
    The spec's decision stands after Phase B: on the shipped model the
    prototype-distance test flags 19% of held-out JTAG/SWD and 26% of PS/2
    at 4% false alarms, which does not earn its area. The verification log
    records Phase B's design findings (gradient training underfitting, noisy
    model selection, the loss of abstention and how MARGIN now handles it),
    the local gate-level limitation, and the planted bugs for the class
    pins and the prescaler. The README's built-and-tested list is dated to
    commit 353dc90.
2026-11-09 Flow: set SYNTH_STRATEGY to AREA 0
    LibreLane 3.1.0.dev4, which the ttihp27a action installs, changed the
    default synthesis strategy from AREA 0 to DELAY 4. The same RTL went
    from 27,789 cells to 44,393. Set AREA 0, the setting every 6x4 run
    used, so this commit's GDS run measures the difference.
2026-11-10 Ear: per-class confidence margins (EAR_MARGIN_K)
    A window is confident when its best logit beats the second by at least
    the margin of the class it is called, set at 0xD0 + k. Writing
    EAR_MARGIN (0xB4) still sets all eight, so a host that writes one
    margin sees no change. 56 more flip-flops and an 8-way byte select.
    The reference model, harness and evaluation use the per-class margin;
    calibrate_classes sets each class against its own validation windows
    and shares the 5% foreign budget between classes. New RTL tests check
    the registers and margins placed at the windows' own gaps; the second
    catches confidence judged against class 0's margin, the wrong class's
    margin, or with > instead of >=.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
2026-11-10 Ear: ship per-class margins; report and docs
    The seeded retrain reproduces the shipped weights exactly and sets
    margins UART 44, SPI 9, I2C 10, USB-LS 25, CAN 59, JTAG/SWD 57, PS/2 23,
    Manchester 47. Confident test windows go from 21% to 58%, 99.9% right;
    USB-LS, I2C and PS/2 become confident on most windows. CAN stays at 0%
    and UART is rare. Held-out foreign windows are confident 10.5% of the
    time on the confident bit (7.0% before): the margins overfit their 30
    calibration windows. Recorded in the README, spec and verification log
    with the planted bugs.
2026-11-10 Docs: the AREA 0 run at 8x4
    Commit f45ddf0's GDS run synthesised 32,802 cells and placed 620,146
    um2, 51.3% of the 8x4 core (734,901 um2 and 60.8% under DELAY 4). Slow
    corner setup slack +5.20 ns, typical +9.22, fast +11.53, worst hold
    +0.10 ns; DRC, antenna and LVS clean.
